AdamSeidman/SDAQ/README.md

# SDAQ
Stackable Data Acquisition System for RIT Baja.
