AdamSeidman/SDAQ/Boards/ADC Board/RevB/Gerber/SDAQ_ADCBoard_RevB.png

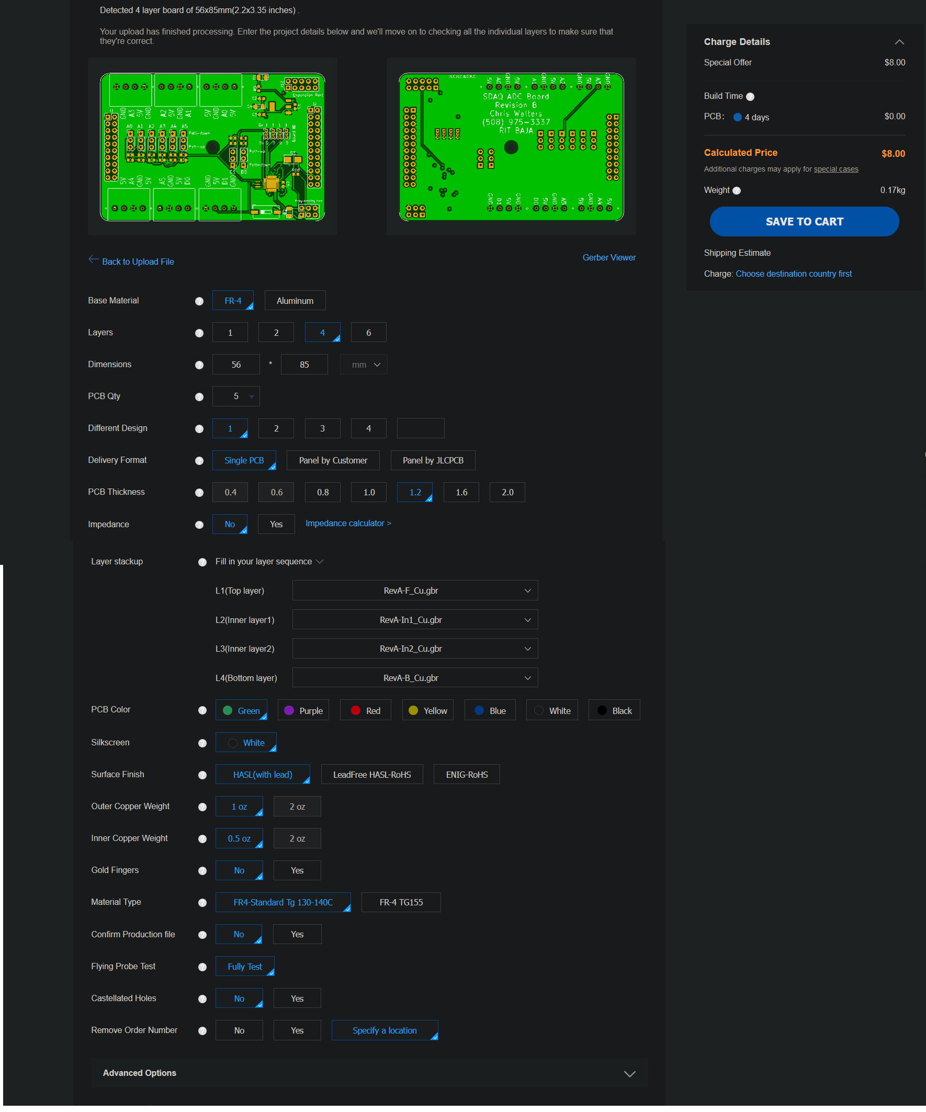
Boards/ADC Board/RevB/Gerber/SDAQ_ADCBoard_RevB.png
