AdamSeidman/SDAQ/Boards/Main Board/#Gerber/#Zips/Main_Board-RevB.png

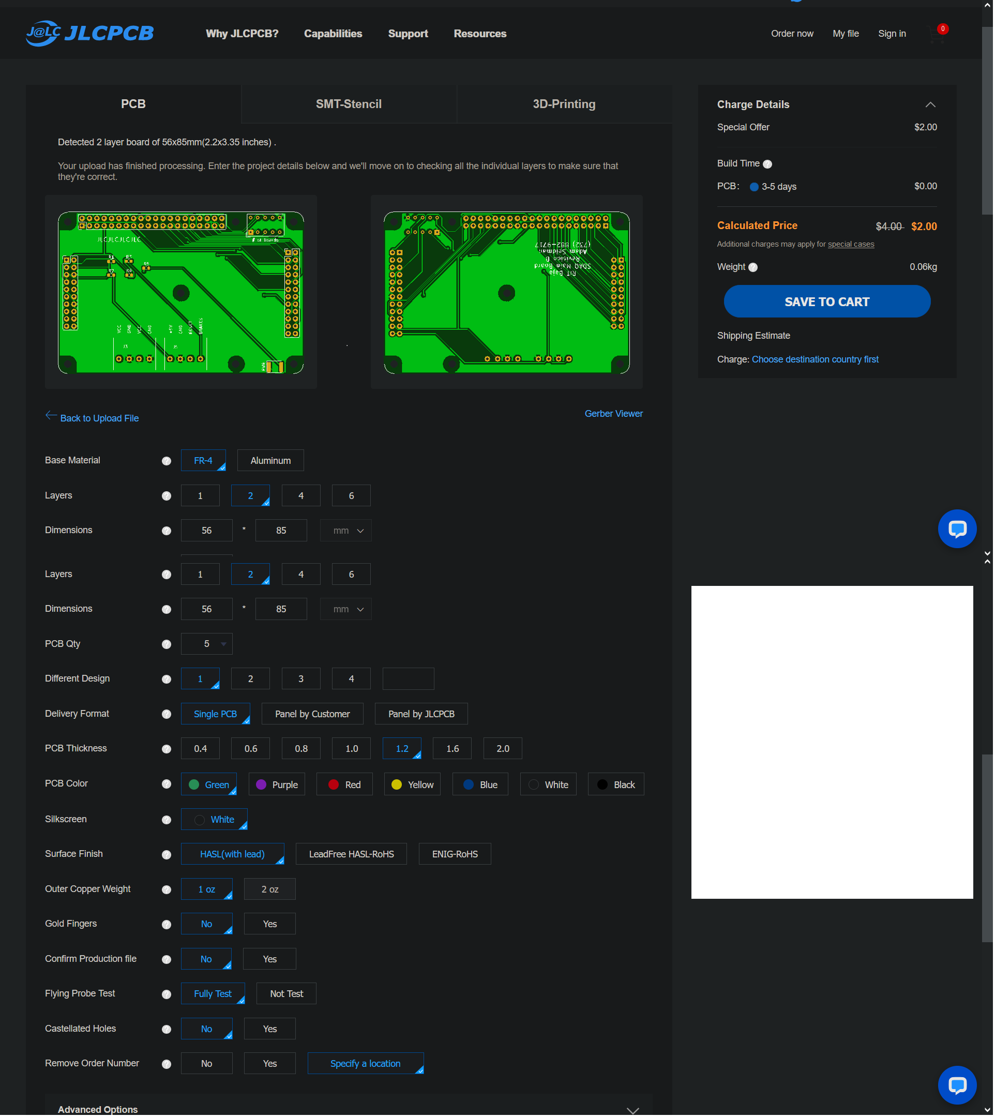
Boards/Main Board/#Gerber/#Zips/Main_Board-RevB.png
