AdamSeidman/SDAQ/Boards/Main Board/#Gerber/pcb_options.png

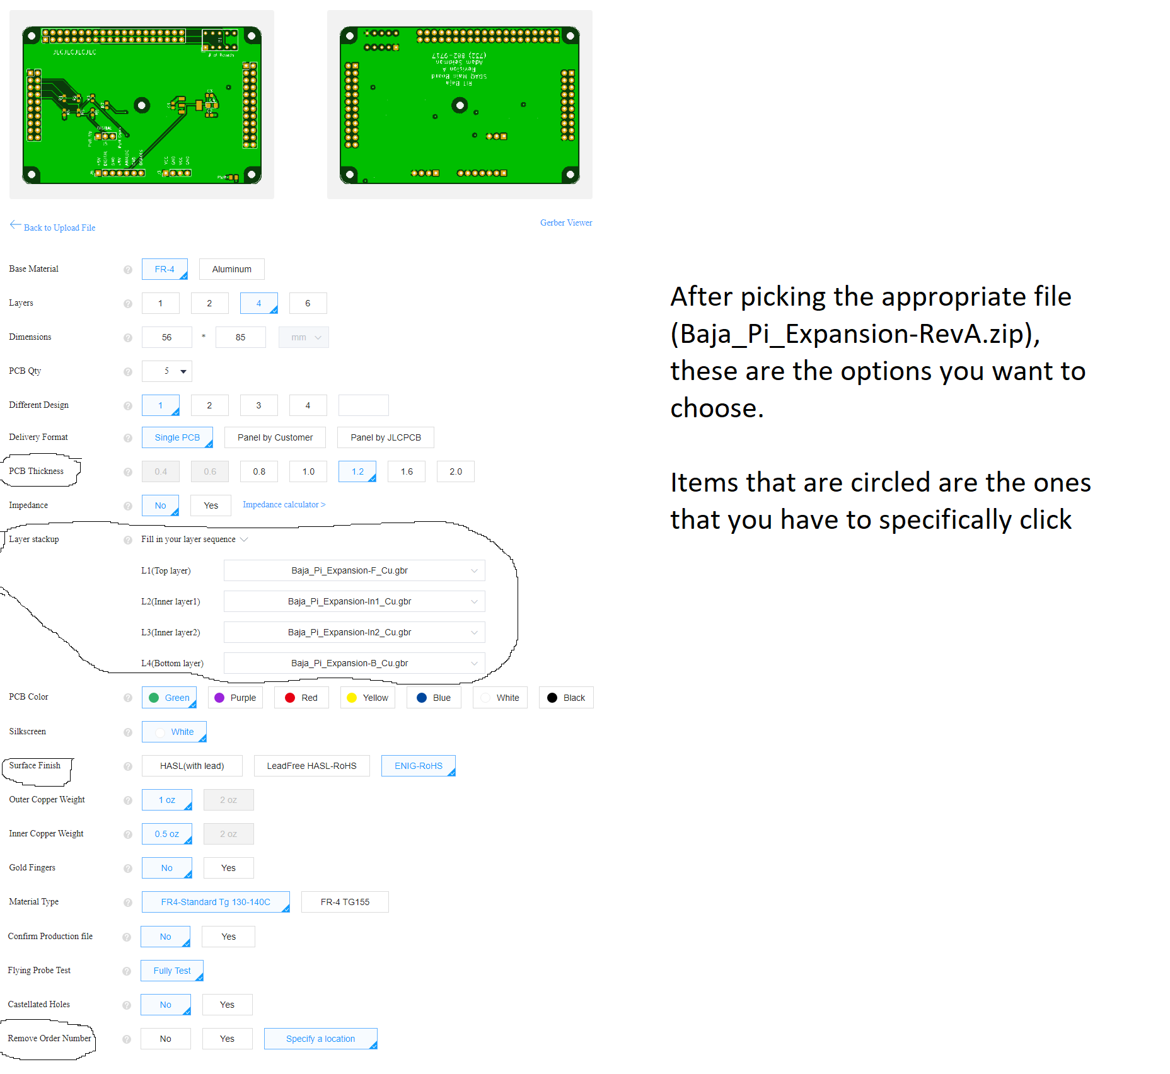
Boards/Main Board/#Gerber/pcb_options.png
