AdamSeidman/SDAQ/Resources/GPIO Pins for Raspberry Pi 4 (1).jpg

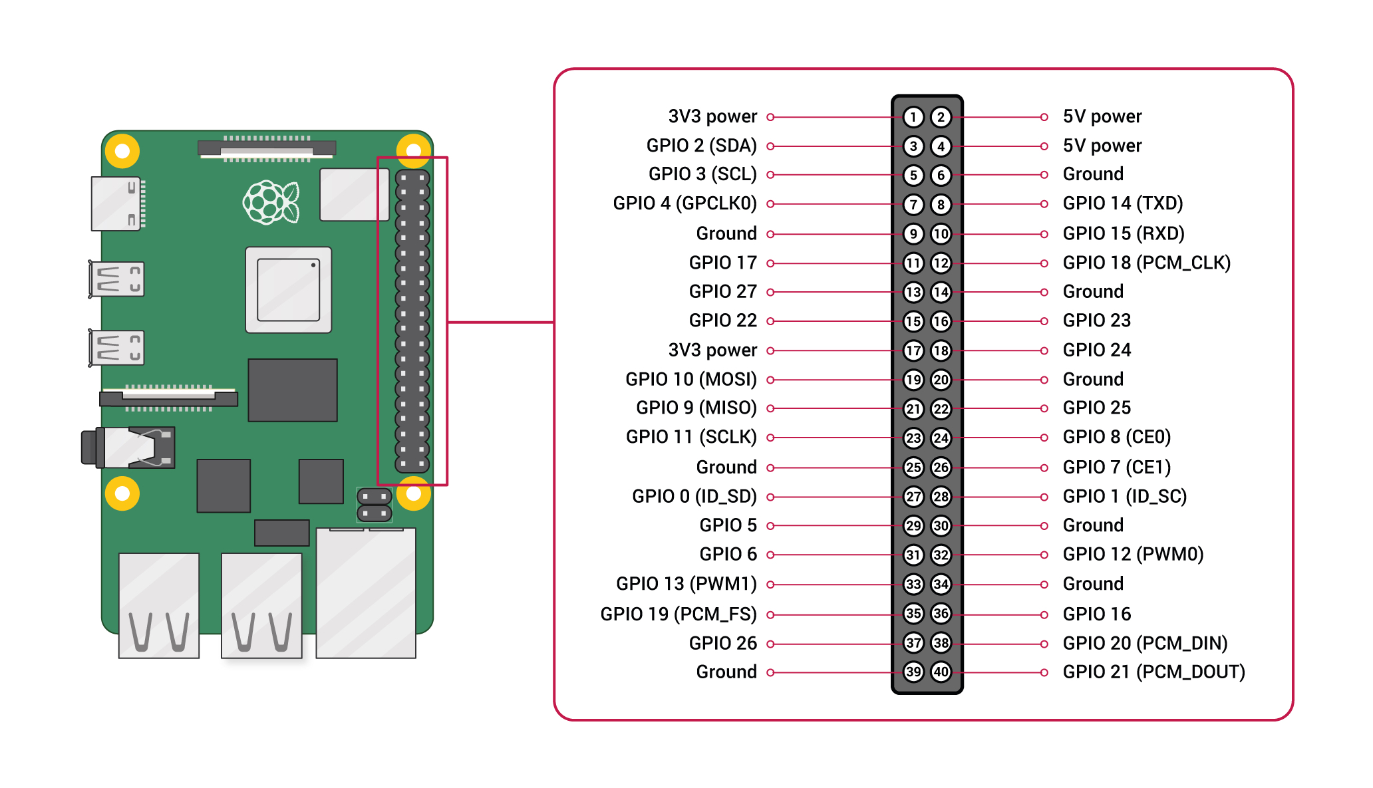
Resources/GPIO Pins for Raspberry Pi 4 (1).jpg
