AdamSeidman/SDAQ/Resources/GPIO Pins for Raspberry Pi 4 (2).jpg

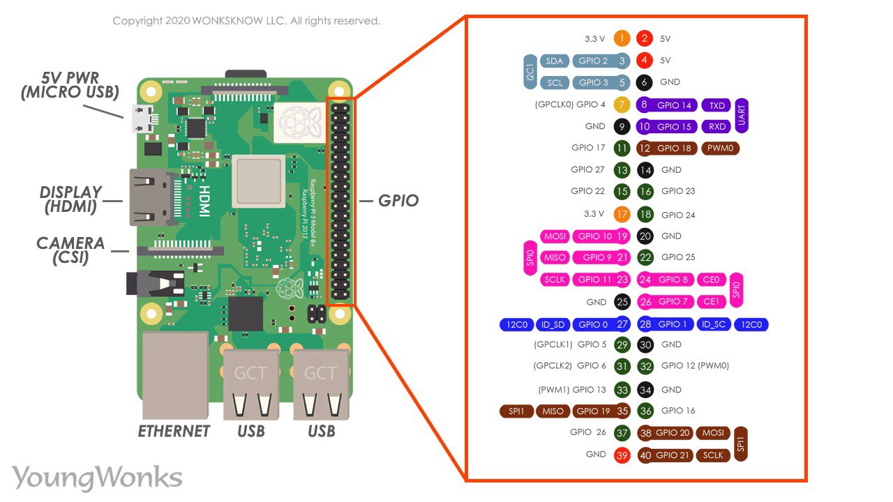
Resources/GPIO Pins for Raspberry Pi 4 (2).jpg
