AdamSeidman/SDAQ/Resources/Strain Gauge Schematic With Notes.png

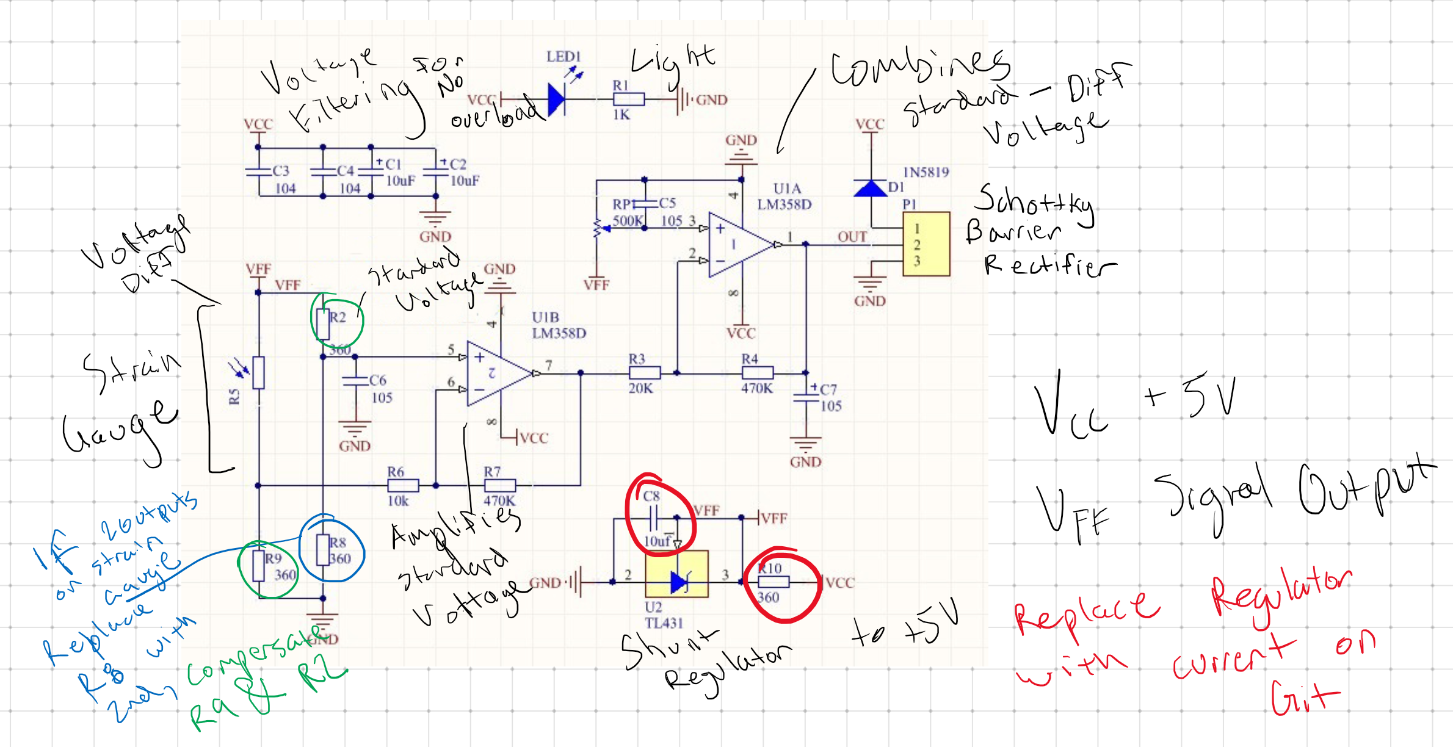
Resources/Strain Gauge Schematic With Notes.png
