AdamSeidman/SDAQ/Orders.xlsx

Sheet: Mouser Order
Description | Part # | Price ($) | Quantity | Total | Total: | 27.02
7 Pin spring terminal block | 651-1985247 | 1.1 | 3 | 3.3
4 Pin spring | 651-1984989 | 0.61 | 3 | 1.83
12 pin | 651-1985292 | 1.67 | 10 | 16.7
5V Regulator | 863-LM1117IMPXADJNOP | 0.519 | 10 | 5.19

Sheet: March 26 Order
Index | Quantity | Part Number | Manufacturer Part Number | Description | Customer Reference | Available | Backorder | Unit Price | Extended Price USD
1 | 10 | 563-CFS-0102CT-ND | CFS-0102TB | SWITCH DIP 1POS SPST 100MA 6V |  | 10 | 0 | 0.774 | 7.74
2 | 10 | 490-CSTNE16M0V53L000R0CT-ND | CSTNE16M0V53L000R0 | 3.2X1.3MM 16.0MHZ CERAMIC RESONA |  | 10 | 0 | 0.225 | 2.25
3 | 10 | LT1117CST-5#TRPBFCT-ND | LT1117CST-5#TRPBF | IC REG LINEAR 5V 800MA SOT223-3 |  | 10 | 0 | 5.172 | 51.72
4 | 50 | SAM12304-ND | TSW-103-14-F-S | CONN HEADER VERT 3POS 2.54MM |  | 50 | 0 | 0.381 | 19.05
5 | 30 | S9337-ND | QPC02SXGN-RC | CONN JUMPER SHORTING .100" GOLD |  | 30 | 0 | 0.0408 | 1.22
6 | 30 | 277-5744-ND | 1751264 | TERM BLK 4POS SIDE ENT 3.5MM PCB |  | 30 | 0 | 2.749 | 82.47
7 | 13 | Z2929-ND | G5Q-14 DC5 | RELAY GEN PURPOSE SPDT 10A 5V |  | 13 | 0 | 1.556 | 20.23
8 | 10 | SAM11096-ND | ESQ-110-13-L-D | CONN SOCKET 20POS 0.1 GOLD PCB |  | 10 | 0 | 6.01 | 60.1
9 | 5 | ESQ-120-13-T-D-ND | ESQ-120-13-T-D | CONN SOCKET 40POS 0.1 TIN PCB |  | 5 | 0 | 7.64 | 38.2
10 | 8 | SAM1204-12-ND | SSQ-112-03-T-D | CONN RCPT 24POS 0.1 TIN PCB |  | 8 | 0 | 2.56 | 20.48
11 | 7 | SAM11124-ND | ESW-105-12-L-D | CONN SOCKET 10POS 0.1 GOLD PCB |  | 7 | 0 | 2.99 | 20.93
12 | 7 | 609-77313-127-10LF-ND | 77313-127-10LF | CONN HEADER VERT 10POS 2.54MM |  | 7 | 0 | 0.62 | 4.34
13 | 7 | S2212EC-03-ND | PREC003DFAN-RC | CONN HEADER VERT 6POS 2.54MM |  | 7 | 0 | 0.16 | 1.12
14 | 20 | 296-52901-ND | LM358DG4 | IC OPAMP GP 2 CIRCUIT 8SOIC |  | 20 | 0 | 0.879 | 17.58
15 | 7 | BCS-103-T-D-TE-ND | BCS-103-T-D-TE | CONN RCPT 6POS 0.1 TIN PCB |  | 7 | 0 | 1.84 | 12.88
16 | 10 | 1195-6406-ND | 21348081380050 | CBL 3POS MALE TO FMALE 16.4' |  | 10 | 0 | 14.283 | 142.83

Sheet: Digikey Order
Description | Part # | Price ($) | Quantity | Total | Notes | Total: | 97.535
02x10 Pin Header F | S6106-ND | 1.26 | 3 | 3.78
02x12 Pin Header F | S7080-ND | 1.46 | 3 | 4.38
02x20 Pin Header F | S6104-ND | 2.29 | 3 | 6.87
7 Segment Display | 516-2271-ND | 3.48 | 3 | 10.44
LED | 1497-XZCDGK53W-8VFCT-ND | 0.413 | 15 | 6.195
Shunt | S9337-ND | 0.0408 | 25 | 1.02
3 Pin Jumper | SAM12304-ND | 0.364 | 10 | 3.64
02x10 Pin Header Thru | SAM1204-10-ND | 1.935 | 10 | 19.35
02x12 Pin Header Thru | SAM1204-12-ND | 2.321 | 10 | 23.21
04x03 Pin Jumper | A122856-ND | 4.39 | 4 | 17.56
1M Ohm | RMCF0805FT1M00CT-ND | 0.0109 | 100 | 1.09

Sheet: Amazon Order
Description | Price ($) | Quantity | Total | Link | Total: | 14.99
M2.5 Hardware Kit | 14.99 | 1 | 14.99 | https://www.amazon.com/Pastall-Raspberry-Installation-Standoff-Accessories/dp/B08MF8LDBS
