AdamSeidman/SDAQ/Boards/Main Board/Main_Board.xlsx

Sheet: Changelog
Revision A | Created board, Raspberry pi shield with 7 segment display, power terminal, dig-in and analog-in
Revision A1 | Fixed pullup-pulldown jumper on board

Sheet: Parts
Item | Use | PN/URL
02x10 Pin Header F | Left Expansion Header | S6106-ND
02x12 Pin Header F | Right Expansion Header | S7080-ND
02x20 Pin Header F | Pi Header | S6104-ND
7 Pin Screw Terminal | Sensor Input Terminal |  | (see if we have)
4 Pin Screw Terminal | Power Input Terminal |  | (see if we have)
7 Segment Display | # Boards Display | 516-2271-ND
LED | Power LED | 1497-XZCDGK53W-8VFCT-ND
Shunt | (For Jumper) | S9337-ND
3 Pin Jumper | Pullup/Pulldown Choice | SAM12304-ND | 609-3461-ND
5V Regulator | Pi Power Regulator | LM1117IMPX-5.0/NOPBCT-ND
4.7 uF Tantalum Cap | CPU Power Regulator | 478-8292-1-ND
1 uF Capacitor | Power Regulator (Both) | 490-10021-1-ND
0.1 uF Capacitor | Power Regulator (Not CPU) | 1292-1392-1-ND
10k Resistor | Generic Pullup/Pulldown | YAG2321CT-ND
4.7k Resistor | I2C Pullup Resistor | (See MR)
15.4k Resistor (?) | Brakes Divider #1 | (See MR)
(10k) | Brakes Divider #2 | (See Above)
200 Ohm Resistor | Power LED Resistor | P20201CT-ND
02x10 Pin Header Thru | Left Expansion Header | SAM1193-10-ND
02x12 Pin Header Thru | Right Expansion Header | SAM1193-12-ND
04x03 Pin Jumper | Pullup/Pulldown Choice *4 | A122856-ND | TSW-104-08-G-T-ND
M2.5 Hardware Kit | Mounting | https://www.amazon.com/Pastall-Raspberry-Installation-Standoff-Accessories/dp/B08MF8LDBS
