AdamSeidman/SDAQ/Boards/#Parts/keystone-PN1027.STEP

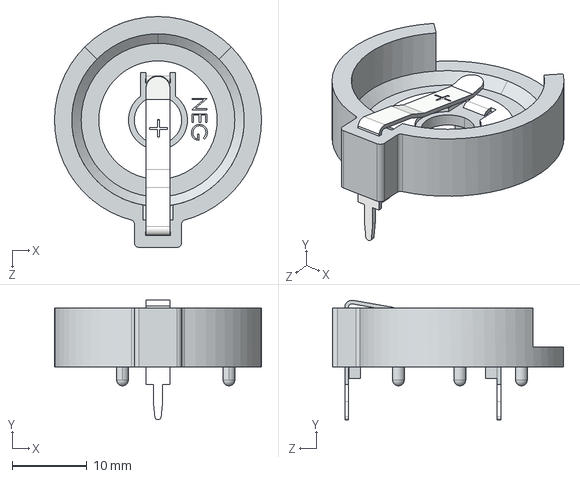
[picture p9: CAD file, 2021-10-08]
Boards/#Parts/keystone-PN1027.STEP
27.8 x 16.0 x 31.0 mm
