AdamSeidman/SDAQ/Boards/#Parts/ul_ATMEGA328PMUR/STEP/32M1-A_ATM.step

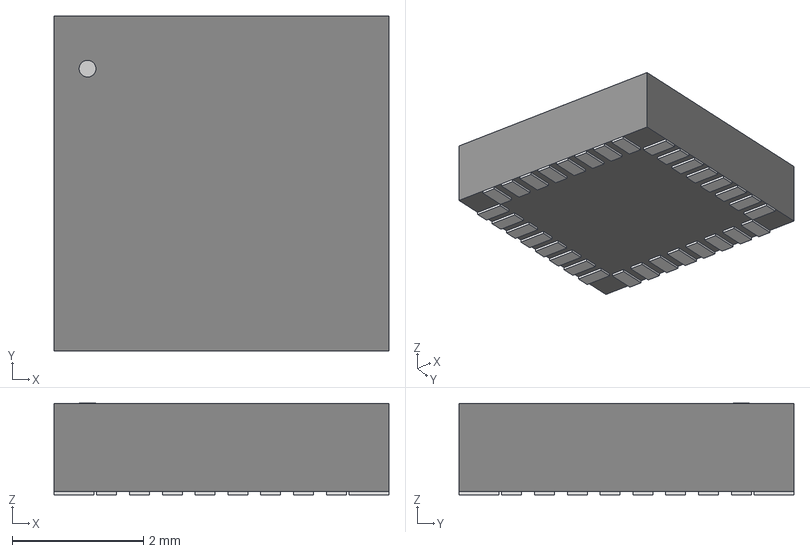
[picture p10: CAD file, 2022-03-16]
Boards/#Parts/ul_ATMEGA328PMUR/STEP/32M1-A_ATM.step
5.11 x 5.11 x 1.40 mm
