AdamSeidman/SDAQ/Boards/Strain_Gauge_Schmatic/LM358/LM358.step

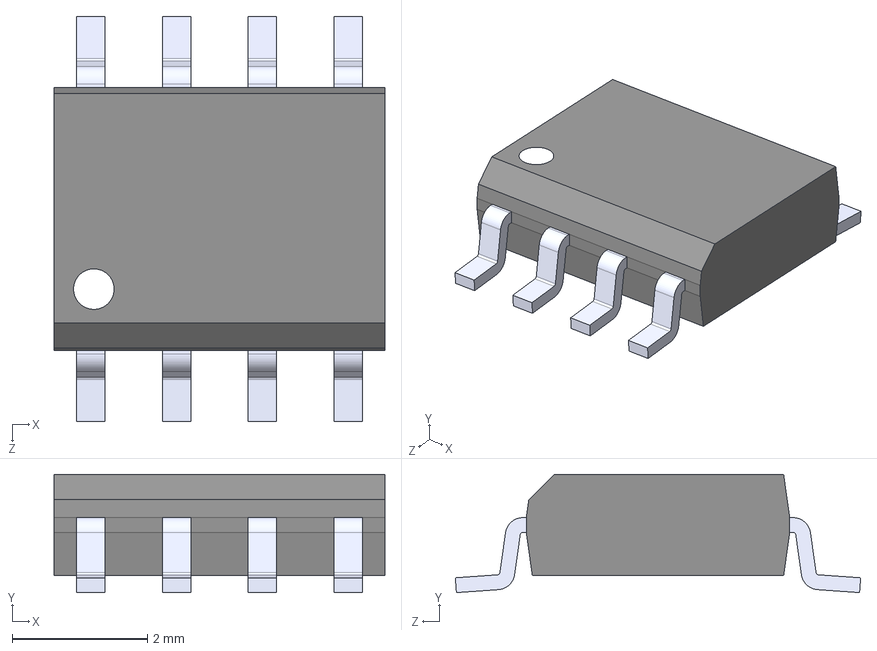
[picture p11: CAD file, 2022-02-05]
Boards/Strain_Gauge_Schmatic/LM358/LM358.step
4.90 x 1.75 x 6.00 mm
