AdamSeidman/SDAQ/Boards/Strain_Gauge_Schmatic/LM358/LM358M_NOPB.step

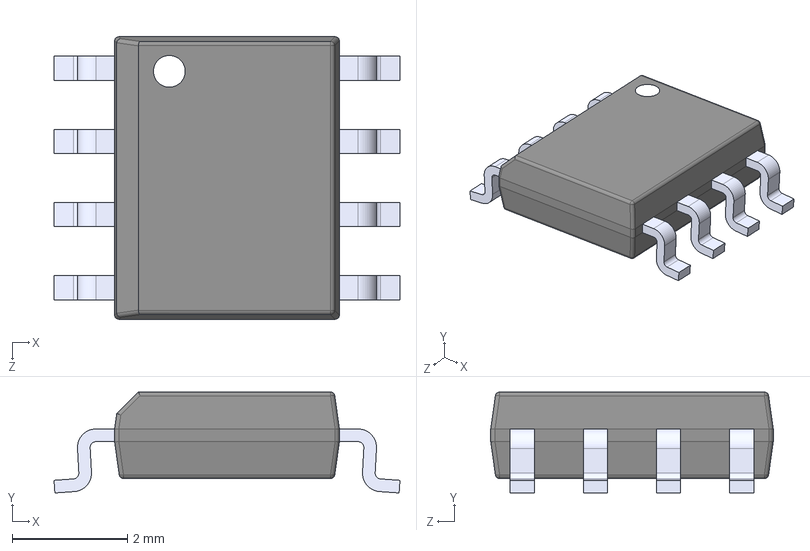
[picture p12: CAD file, 2022-02-05]
Boards/Strain_Gauge_Schmatic/LM358/LM358M_NOPB.step
6.00 x 1.75 x 4.90 mm
