AdamSeidman/SDAQ/Boards/#Parts/Female Pin Headers 3D/s91601-306lf/91601-306LFc.stp

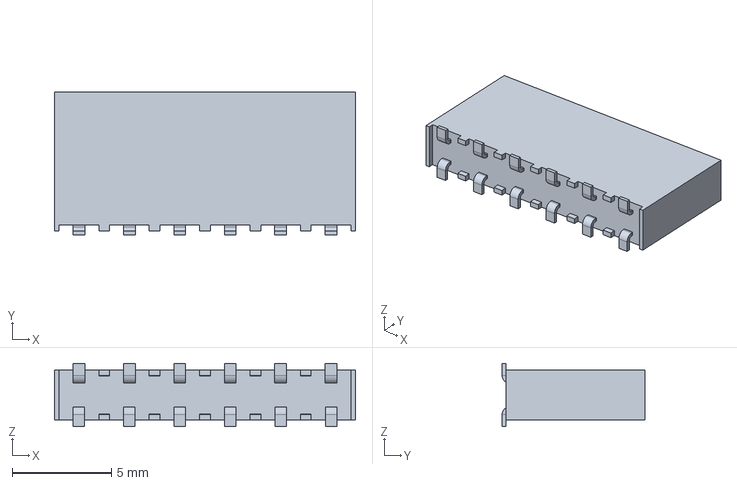
[picture p13: CAD file, 2021-10-08]
Boards/#Parts/Female Pin Headers 3D/s91601-306lf/91601-306LFc.stp
15.2 x 7.20 x 3.19 mm
