AdamSeidman/SDAQ/Boards/#Parts/Female Pin Headers 3D/s91601-308lf/91601-308LFc.stp

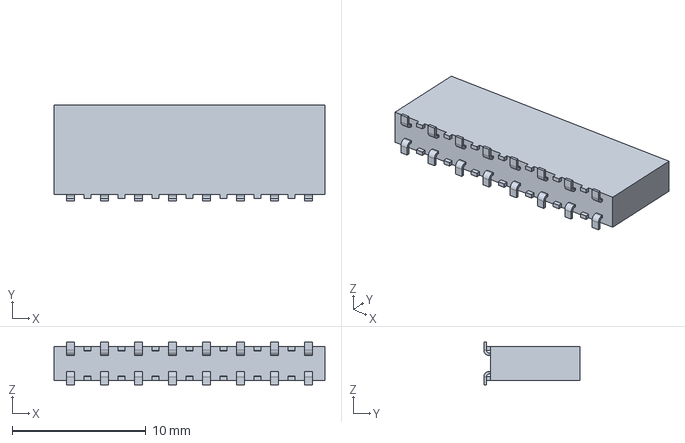
[picture p14: CAD file, 2021-10-08]
Boards/#Parts/Female Pin Headers 3D/s91601-308lf/91601-308LFc.stp
20.2 x 7.20 x 3.19 mm
