AdamSeidman/SDAQ/Boards/#Parts/Female Pin Headers 3D/s91601-412alf/91601-412ALFc.stp

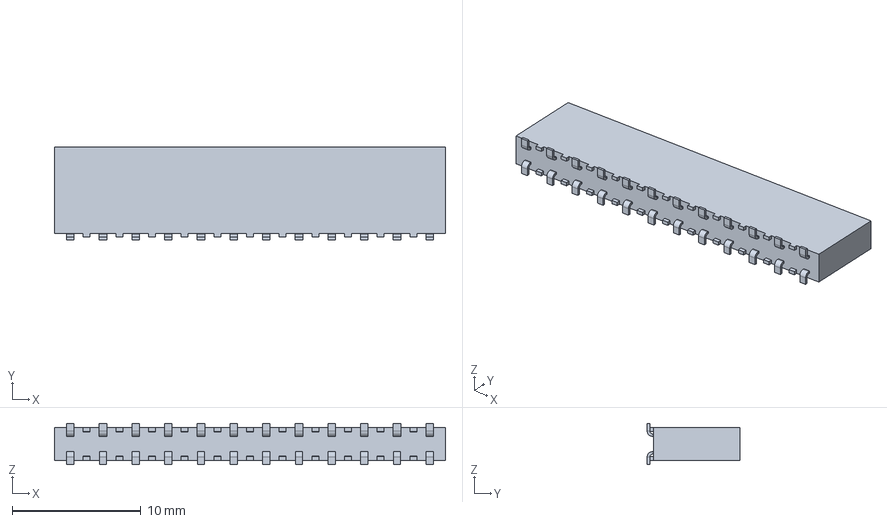
[picture p15: CAD file, 2021-10-08]
Boards/#Parts/Female Pin Headers 3D/s91601-412alf/91601-412ALFc.stp
30.4 x 7.20 x 3.19 mm
