AdamSeidman/SDAQ/(list of files, cad)

Other CAD files:
Boards/#Parts/ul_ATMEGA328PMUR/STEP/32M1-A_ATM-M.step
Boards/#Parts/ul_ATMEGA328PMUR/STEP/32M1-A_ATM-L.step
