AdamSeidman/SDAQ/Boards/Breadboard_Testbed/RevA/Gerber/Breadboard_Testbed-RevA.png

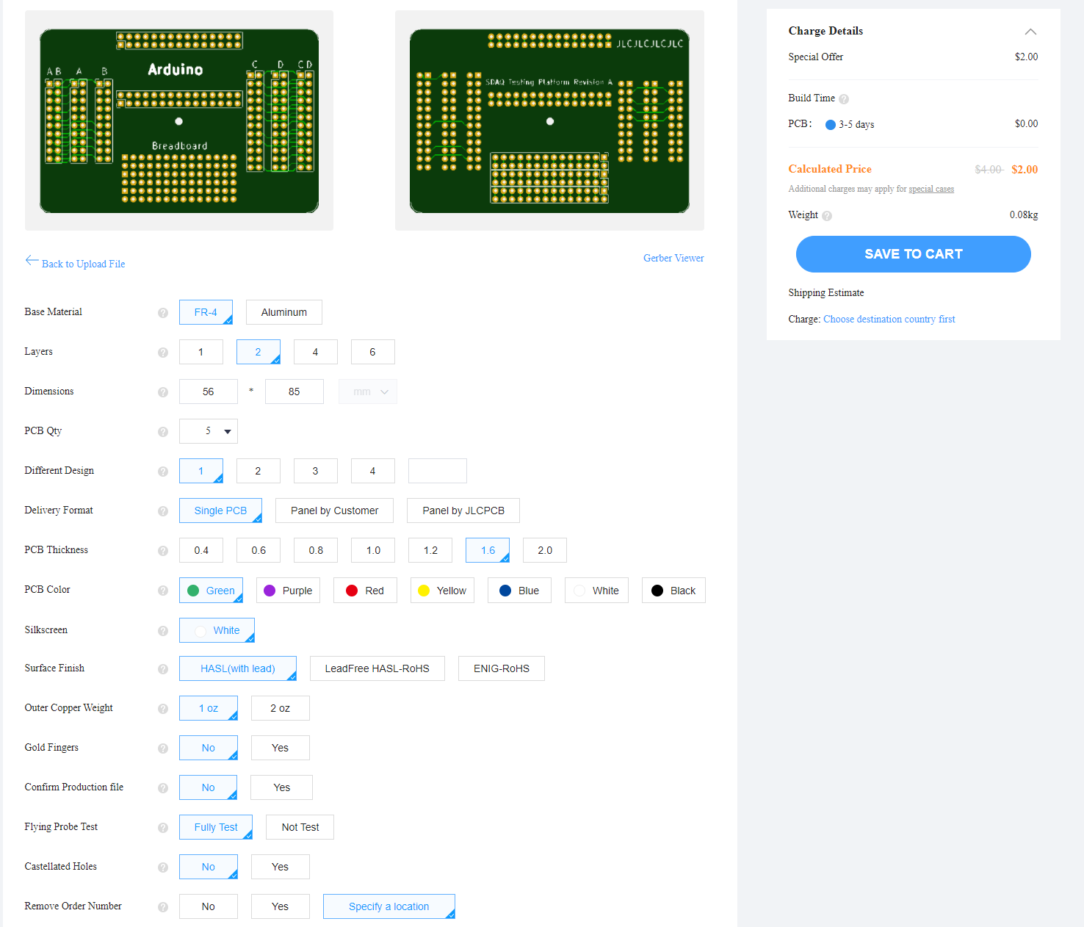
Boards/Breadboard_Testbed/RevA/Gerber/Breadboard_Testbed-RevA.png
