AdamSeidman/SDAQ/Data/4_22_Calibration/Notebook-Images/IMG20220423190747.jpg

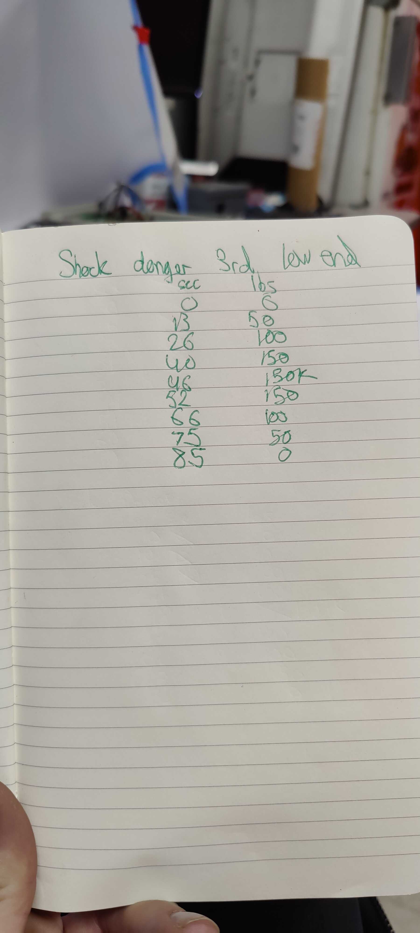
Data/4_22_Calibration/Notebook-Images/IMG20220423190747.jpg
