AdamSeidman/SDAQ/(list of files, drawings)

Other design files:
Boards/ADC Board/RevB/RevB1.dsn
Boards/ADC Board/RevB/RevB.dsn
Boards/Brakes Relay Board/RevB/relay_board.dsn
Boards/Breadboard_Testbed/RevA/Breadboard-Testbed.dsn
Boards/Main Board/RevB/Baja_Pi_Expansion/Baja_Pi_Expansion.dsn
Boards/Main Board/RevC/Baja_Pi_Expansion/Baja_Pi_Expansion.dsn
Boards/Main Board/RevD/Baja_Pi_Expansion/Baja_Pi_Expansion.dsn
Boards/Strain_Gauge_Schmatic/Strain_Guage_Schematic.dsn
