AdamSeidman/SDAQ/Boards/Brakes Relay Board/RevB/relay_board.kicad_pcb

## KiCad design Boards/Brakes Relay Board/RevB/relay_board.kicad_pcb (2022-05-28)

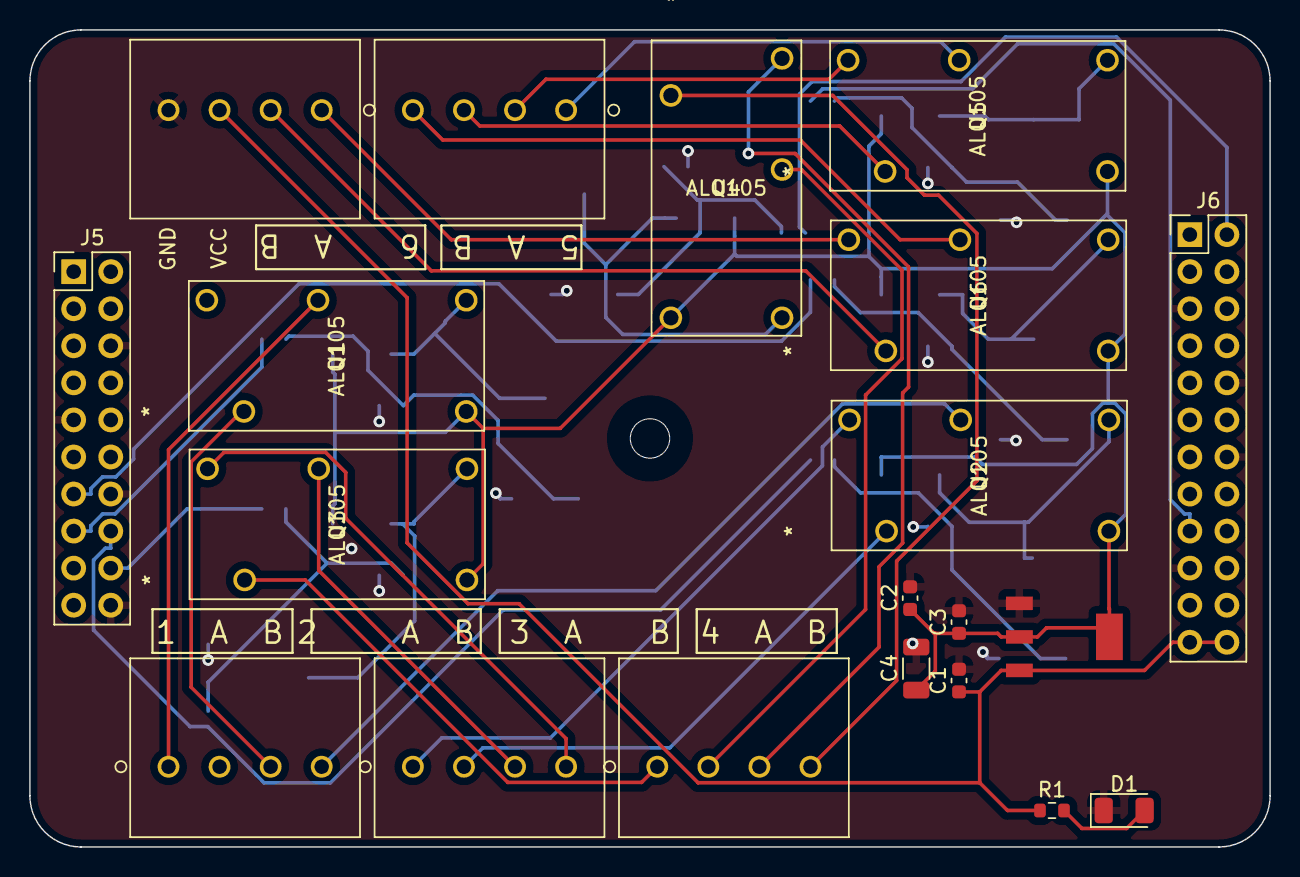
[picture p20: board relay_board.kicad_pcb from above]

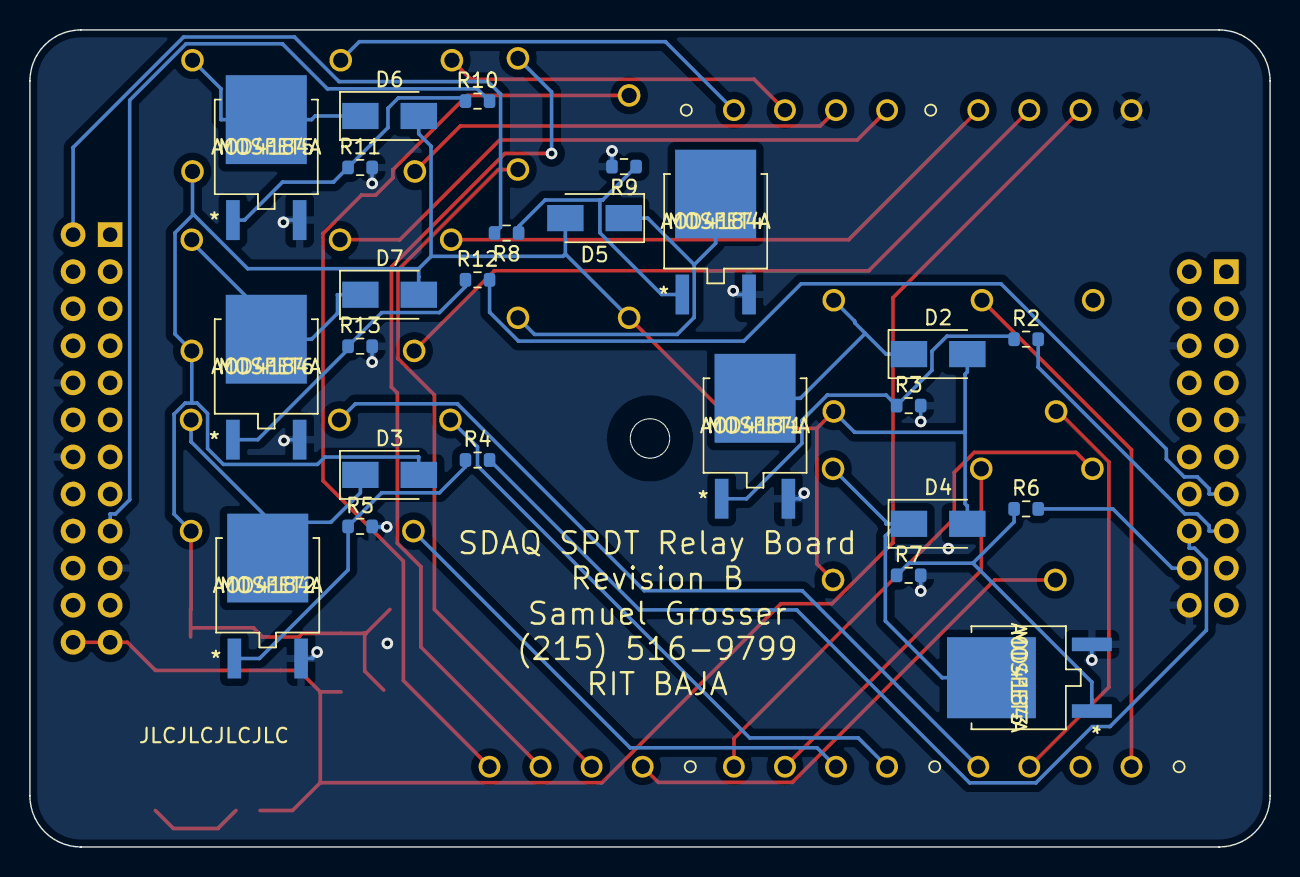
[picture p21: board relay_board.kicad_pcb from below]

Board: 2 copper layers, 85.0 x 56.0 mm, 44 parts (24 on the bottom side), 39 nets.

Parts:
C1, C2, C3: C_0603_1608Metric
C4: C_1206_3216Metric
D1: LED; D_1206_3216Metric
D2, D3, D4, D5, D6, D7: DIODE; D_SMA
J1, J2, J3, J4, J7: Screw_Terminal_01x04; 1984989
J5: Conn_02x10_Counter_Clockwise; PinHeader_2x10_P2.54mm_Vertical
J6: Conn_02x12_Counter_Clockwise; PinHeader_2x12_P2.54mm_Vertical
MOSFET1, MOSFET2, MOSFET3, MOSFET4, MOSFET5, MOSFET6: AOD4184A
R1: 1800; R_0603_1608Metric
R2, R4, R6, R8, R10, R12: 100; R_0603_1608Metric
R3, R5, R7, R9, R11, R13: 100k; R_0603_1608Metric
U1, U2, U3, U4, U5, U6: ALQ105
VR1: SOT230P700X180-4N

Connections:
+5V: C2.1, C3.1, C4.1, D2.2 (A), D3.2 (A), D4.2 (A), D5.2 (A), D6.2 (A), D7.2 (A), U1.4, U2.4, U3.4, U4.4, U5.4, U6.4, VR1.2 (VOUT2), VR1.4 (VOUT)
/Ch1: J1.1, U1.2
/Ch1B: J1.3, U1.5
/Ch2: J1.4, U2.2
/Ch2A: J2.1, U2.1
/Ch2B: J2.2, U2.5
/Ch3: J2.3, U3.2
/Ch3A: J2.4, U3.1
/Ch3B: J3.1, U3.5
/Ch4: J3.2, U4.2
/Ch4A: J3.3, U4.1
/Ch4B: J3.4, U4.5
/Ch5: J4.1, U5.2
/Ch5A: J4.2, U5.1
/Ch5B: J4.3, U5.5
/Ch6: J4.4, U6.2
/Ch6A: J7.1, U6.1
/Ch6B: J7.2, U6.5
/R0: J5.15, R2.2
/R1: J5.16, R4.2
/R2: J5.18, R6.2
/R3: J6.2, R8.2
/R4: J6.17, R10.2
/R5: J5.13, R12.2
/VCC: C1.1, J6.23, J6.24, J7.3, R1.1, VR1.3 (VIN)
GNDREF: C1.2, C2.2, C3.2, C4.2, D1.1 (K), J5.6, J5.9, J5.14, J5.20, J6.5, J6.10, J6.14, J6.19, J7.4, MOSFET1.3, MOSFET2.3, MOSFET3.3, MOSFET4.3, MOSFET5.3, MOSFET6.3, R3.2, R5.2, R7.2, R9.2, R11.2, R13.2, VR1.1 (ADJ/GND)
unnamed: D1.2 (A), R1.2
unnamed: D2.1 (K), MOSFET1.2, U1.3
unnamed: D3.1 (K), MOSFET2.2, U2.3
unnamed: D4.1 (K), MOSFET3.2, U3.3
unnamed: D5.1 (K), MOSFET4.2, U4.3
unnamed: D6.1 (K), MOSFET5.2, U5.3
unnamed: D7.1 (K), MOSFET6.2, U6.3
unnamed: MOSFET1.1, R2.1, R3.1
unnamed: MOSFET2.1, R4.1, R5.1
unnamed: MOSFET3.1, R6.1, R7.1
unnamed: MOSFET4.1, R8.1, R9.1
unnamed: MOSFET5.1, R10.1, R11.1
unnamed: MOSFET6.1, R12.1, R13.1
