AdamSeidman/SDAQ/Boards/Main Board/RevD/Baja_Pi_Expansion/Baja_Pi_Expansion.kicad_pcb

## KiCad design Boards/Main Board/RevD/Baja_Pi_Expansion/Baja_Pi_Expansion.kicad_pcb (2022-04-19)

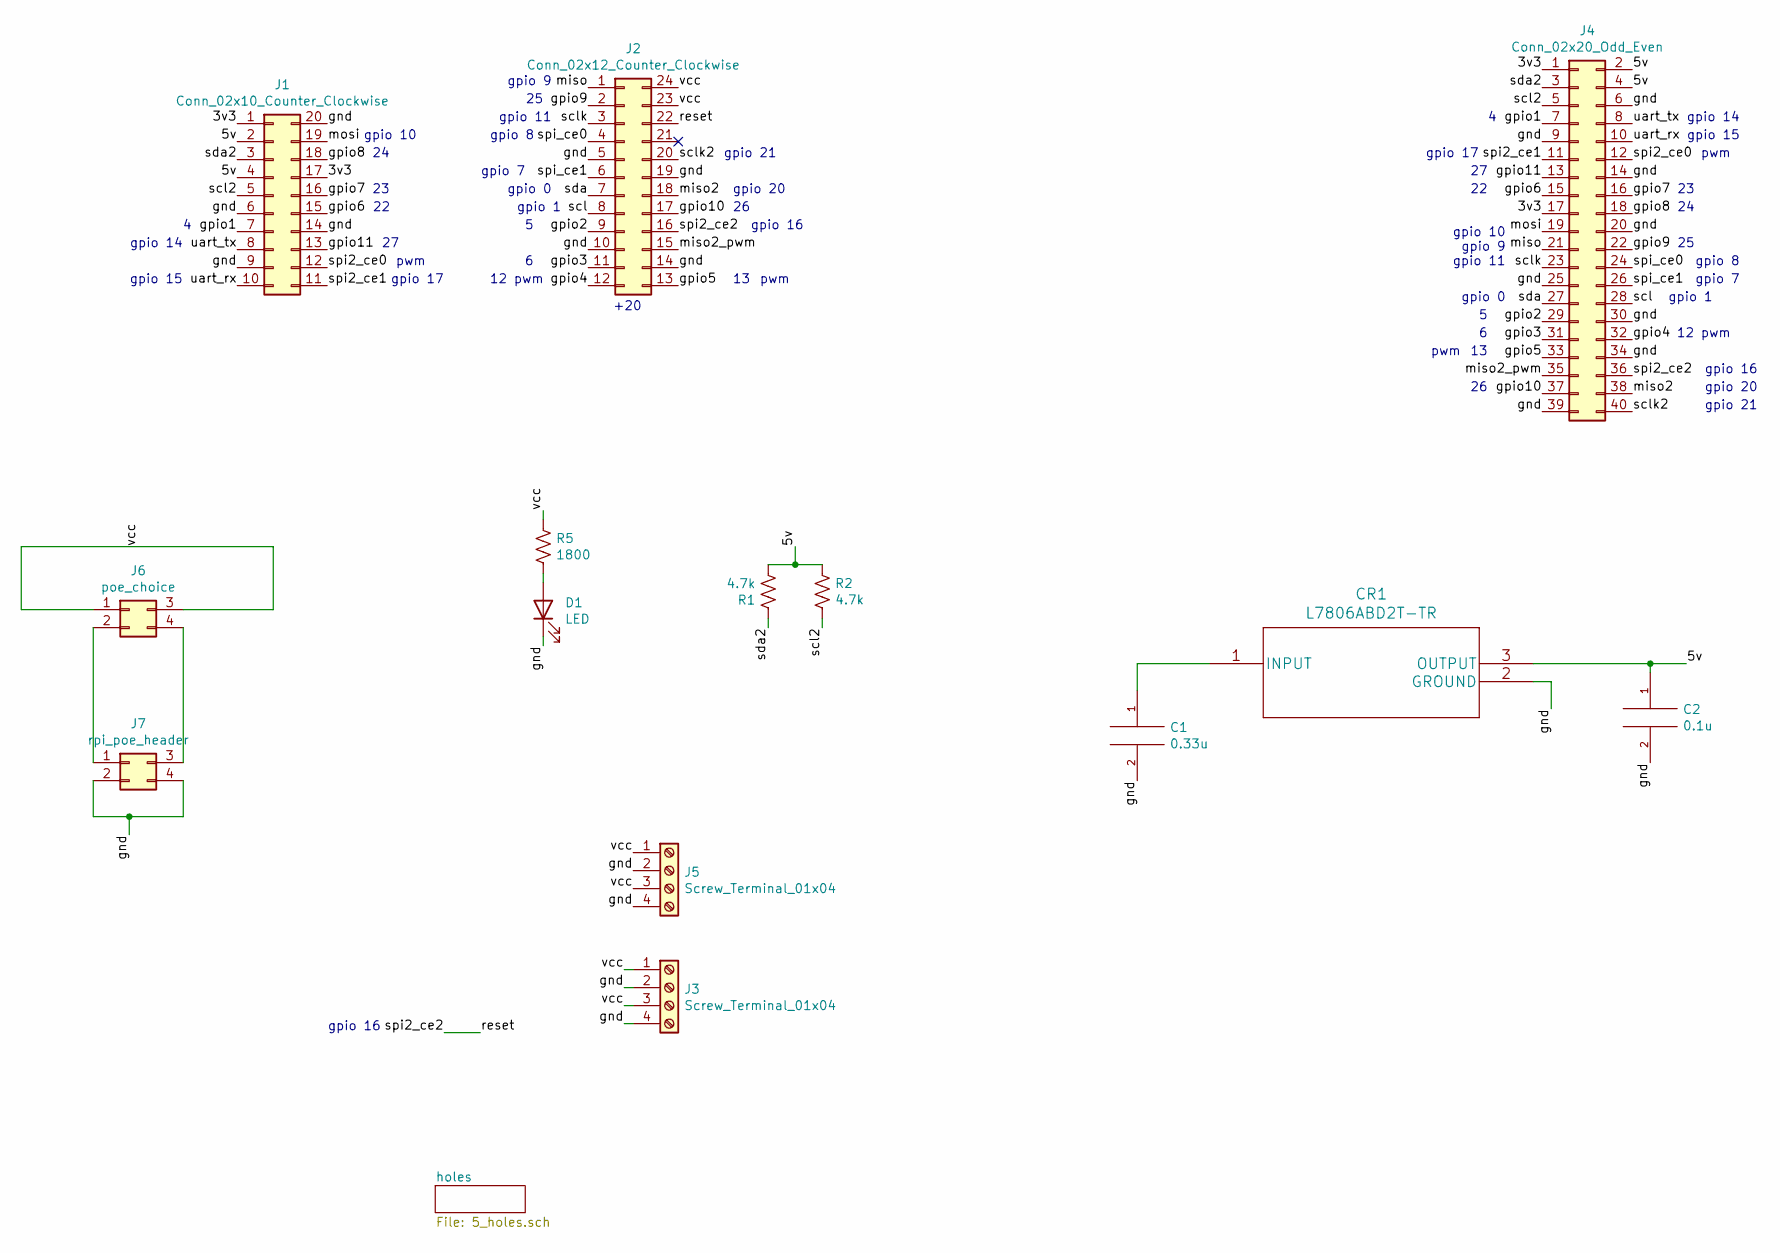
[picture p22: schematic Baja_Pi_Expansion.sch]

Parts:
C1: 0.33u; C_0603_1608Metric
C2: 0.1u; C_0603_1608Metric
CR1: L7806ABD2T-TR
D1: LED; D_1206_3216Metric
J1: Conn_02x10_Counter_Clockwise; PinHeader_2x10_P2.54mm_Vertical
J2: Conn_02x12_Counter_Clockwise; PinHeader_2x12_P2.54mm_Vertical
J3, J5: Screw_Terminal_01x04; Spring_4
J4: Conn_02x20_Odd_Even; PinHeader_2x20_P2.54mm_Vertical
J6: poe_choice; PinHeader_2x02_P2.54mm_Vertical
J7: rpi_poe_header; PinHeader_2x02_P2.54mm_Vertical
R1, R2: 4.7k; R_0603_1608Metric
R5: 1800; R_0603_1608Metric

Connections:
/3v3: J1.1, J1.17, J4.1, J4.17
/5v: C2.1, CR1.3 (OUTPUT), J1.2, J1.4, J4.2, J4.4, R1.1, R2.2
/gnd: C1.2, C2.2, CR1.2 (GROUND), D1.1 (K), J1.6, J1.9, J1.14, J1.20, J2.5, J2.10, J2.14, J2.19, J3.2, J3.4, J4.6, J4.9, J4.14, J4.20, J4.25, J4.30, J4.34, J4.39, J5.2, J5.4, J7.2, J7.4
/gpio1: J1.7, J4.7
/gpio2: J2.9, J4.29
/gpio3: J2.11, J4.31
/gpio4: J2.12, J4.32
/gpio5: J2.13, J4.33
/gpio6: J1.15, J4.15
/gpio7: J1.16, J4.16
/gpio8: J1.18, J4.18
/gpio9: J2.2, J4.22
/gpio10: J2.17, J4.37
/gpio11: J1.13, J4.13
/miso: J2.1, J4.21
/miso2: J2.18, J4.38
/miso2_pwm: J2.15, J4.35
/mosi: J1.19, J4.19
/reset: J2.16, J2.22, J4.36
/scl: J2.8, J4.28
/scl2: J1.5, J4.5, R2.1
/sclk: J2.3, J4.23
/sclk2: J2.20, J4.40
/sda: J2.7, J4.27
/sda2: J1.3, J4.3, R1.2
/spi2_ce0: J1.12, J4.12
/spi2_ce1: J1.11, J4.11
/spi_ce0: J2.4, J4.24
/spi_ce1: J2.6, J4.26
/uart_rx: J1.10, J4.10
/uart_tx: J1.8, J4.8
/vcc: J2.23, J2.24, J3.1, J3.3, J5.1, J5.3, J6.1, J6.3, R5.1
unnamed: C1.1, CR1.1 (INPUT)
unnamed: D1.2 (A), R5.2
unnamed: J6.2, J7.1
unnamed: J6.4, J7.3

Notes on the sheet:
pwm
gpio 14
gpio 15
gpio 17
gpio 8
gpio 7
gpio 1
12 pwm
gpio 16
gpio 20
gpio 21
gpio 10 gpio 9 gpio 11
gpio 0
gpio 11
gpio 10
gpio 9
+20

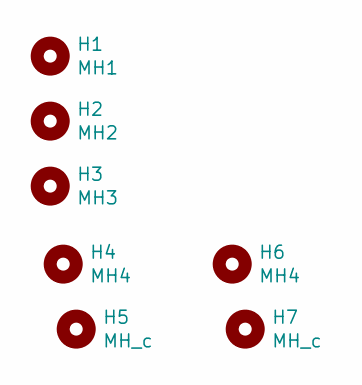
[picture p23: schematic 5_holes.sch]

Parts:
H1: MH1; MountingHole_2.7mm_M2.5
H2: MH2; MountingHole_2.7mm_M2.5
H3: MH3; MountingHole_2.7mm_M2.5
H4, H6: MH4; MountingHole_2.7mm_M2.5
H5, H7: MH_c; MountingHole_2.7mm_M2.5

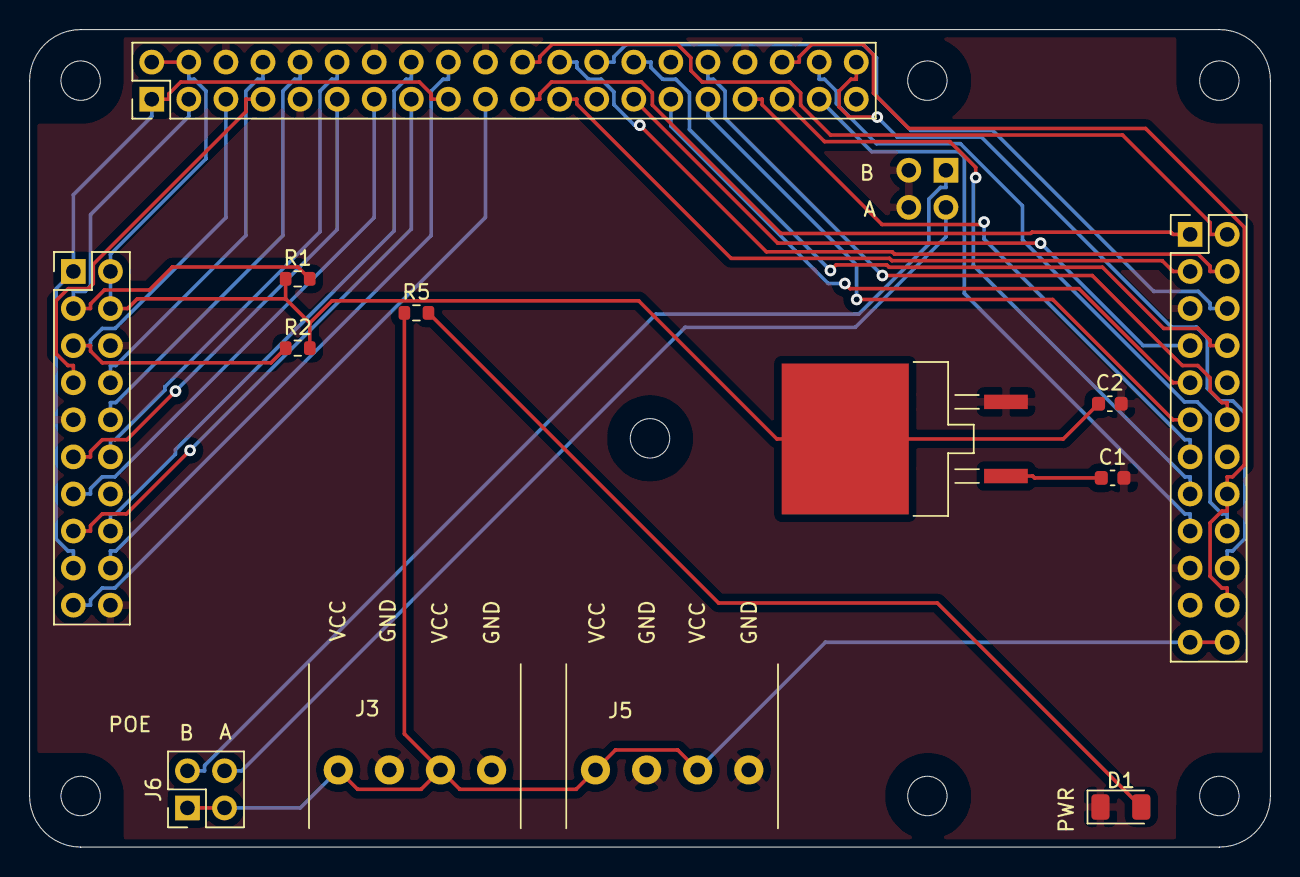
[picture p24: board Baja_Pi_Expansion.kicad_pcb from above]

Board: 2 copper layers, 85.0 x 56.0 mm, 21 parts (1 on the bottom side), 36 nets.
