AdamSeidman/SDAQ/Boards/ADC Board/RevB/RevA.kicad_pcb

## KiCad design Boards/ADC Board/RevB/RevA.kicad_pcb (2022-03-21)

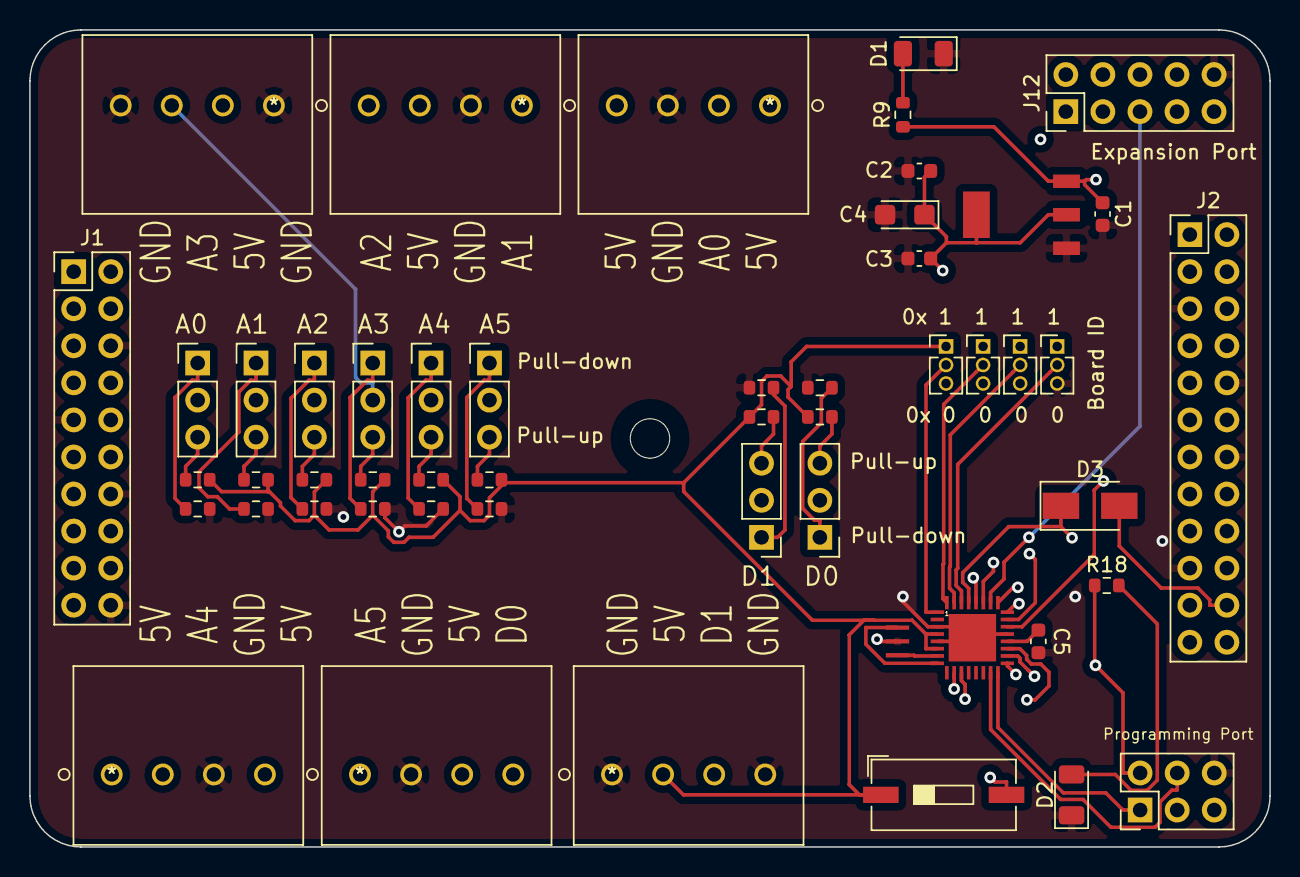
[picture p25: board Boards/ADC Board/RevB/RevA.kicad_pcb from above]

Board: 4 copper layers, 85.0 x 56.0 mm, 53 parts (0 on the bottom side), 45 nets.

Parts:
C1: 0.1uF; C_0603_1608Metric
C2: 1uF; C_0603_1608Metric
C3: 1uF_cpu; C_0603_1608Metric
C4: 4.7uF_16V_cpu; CP_EIA-3216-18_Kemet-A
C5: 100nF; C_0603_1608Metric
D1, D2: LED; LED_1206_3216Metric
D3: DIODE; D_SMA
J1: Left Connector; PinHeader_2x10_P2.54mm_Vertical
J2: Right Connector; PinHeader_2x12_P2.54mm_Vertical
J3, J4, J5, J22: Conn_01x03_Female; PinHeader_1x03_P1.27mm_Vertical
J6, J7, J8, J9, J10, J11: Screw_Terminal_01x04; 1984989
J12: Conn_02x05_Top_Bottom; PinHeader_2x05_P2.54mm_Vertical
J13, J14, J15, J16, J17, J18, J19, J20: Conn_01x03_Male; PinHeader_1x03_P2.54mm_Vertical
J21: Conn_02x03_Odd_Even; PinHeader_2x03_P2.54mm_Vertical
M2.5: CMH; MountingHole_2.7mm_M2.5
R1, R2, R3, R4, R5, R6, R7, R8, R10, R11, R12, R13, R14, R15, R16, R17: 10k; R_0603_1608Metric
R9, R18: 1.8k; R_0603_1608Metric
SW1: SW_DIP_x01; SW_DIP_SPSTx01_Slide_9.78x4.72mm_W8.61mm_P2.54mm
U1: ATMEGA328P-MUR
VR1: LM1117IMPX-5.0; SOT230P700X180-4N
Y1: CSTCE16M0V53-R0; OSC_CSTCE16M0V53-R0

Connections:
/3.3V: J1.1, J1.17
/5V: J3.1, J4.1, J5.1, J6.1, J6.4, J7.3, J8.2, J9.1, J9.4, J10.3, J11.2, J12.1, J21.2, J22.1, R1.2, R3.2, R5.2, R7.2, R10.2, R12.2, R14.2, R16.2, R18.1, SW1.1, U1.4, U1.6, U1.18
/5v_regulator/5V: C2.1, C3.1, C4.1, SW1.2, VR1.2, VR1.4
/A0: J6.2, J12.2, J13.2, U1.23
/A1: J7.1, J12.3, J14.2, U1.24
/A2: J7.4, J12.4, J15.2, U1.25
/A3: J8.3, J12.5, J16.2, U1.26
/A4: J9.2, J12.6, J17.2, U1.19
/A5: J10.1, J12.7, J18.2, U1.22
/A6: J10.4, J12.8, J19.2, U1.10
/A7: J11.3, J12.9, J20.2, U1.11
/Arduino/D0: J3.2, U1.30
/Arduino/D1: J4.2, U1.31
/Arduino/D2: J5.2, U1.32
/Arduino/D3: J22.2, U1.1
/Arduino/MISO: J21.1, U1.16
/Arduino/MOSI: J21.4, U1.15
/Arduino/SCK: J21.3, U1.17
/GND: C1.2, C2.2, C3.2, C4.2, C5.1, D1.1, D2.1, J1.6, J1.9, J1.14, J1.20, J2.5, J2.10, J2.14, J2.19, J3.3, J4.3, J5.3, J6.3, J7.2, J8.1, J8.4, J9.3, J10.2, J11.1, J11.4, J12.10, J21.6, J22.3, R2.2, R4.2, R6.2, R8.2, R11.2, R13.2, R15.2, R17.2, U1.3, U1.5, U1.21, U1.33, VR1.1, Y1.2
/I2C_Clock: J1.5, U1.28
/I2C_Data: J1.3, U1.27
/Reset: D3.2, J21.5, U1.29
/VCC: C1.1, J2.23, J2.24, R9.1, VR1.3
unnamed: C5.2, U1.20
unnamed: D1.2, R9.2
unnamed: D2.2, R18.2
unnamed: D3.1, J2.22
unnamed: J13.1, R2.1
unnamed: J13.3, R1.1
unnamed: J14.1, R4.1
unnamed: J14.3, R3.1
unnamed: J15.1, R6.1
unnamed: J15.3, R5.1
unnamed: J16.1, R8.1
unnamed: J16.3, R7.1
unnamed: J17.1, R11.1
unnamed: J17.3, R10.1
unnamed: J18.1, R13.1
unnamed: J18.3, R12.1
unnamed: J19.1, R15.1
unnamed: J19.3, R14.1
unnamed: J20.1, R17.1
unnamed: J20.3, R16.1
unnamed: U1.7, Y1.1
unnamed: U1.8, Y1.3
