AdamSeidman/SDAQ/Boards/Strain_Gauge_Schmatic/Strain_Guage_Schematic.kicad_pcb

## KiCad design Boards/Strain_Gauge_Schmatic/Strain_Guage_Schematic.kicad_pcb (2022-02-14)

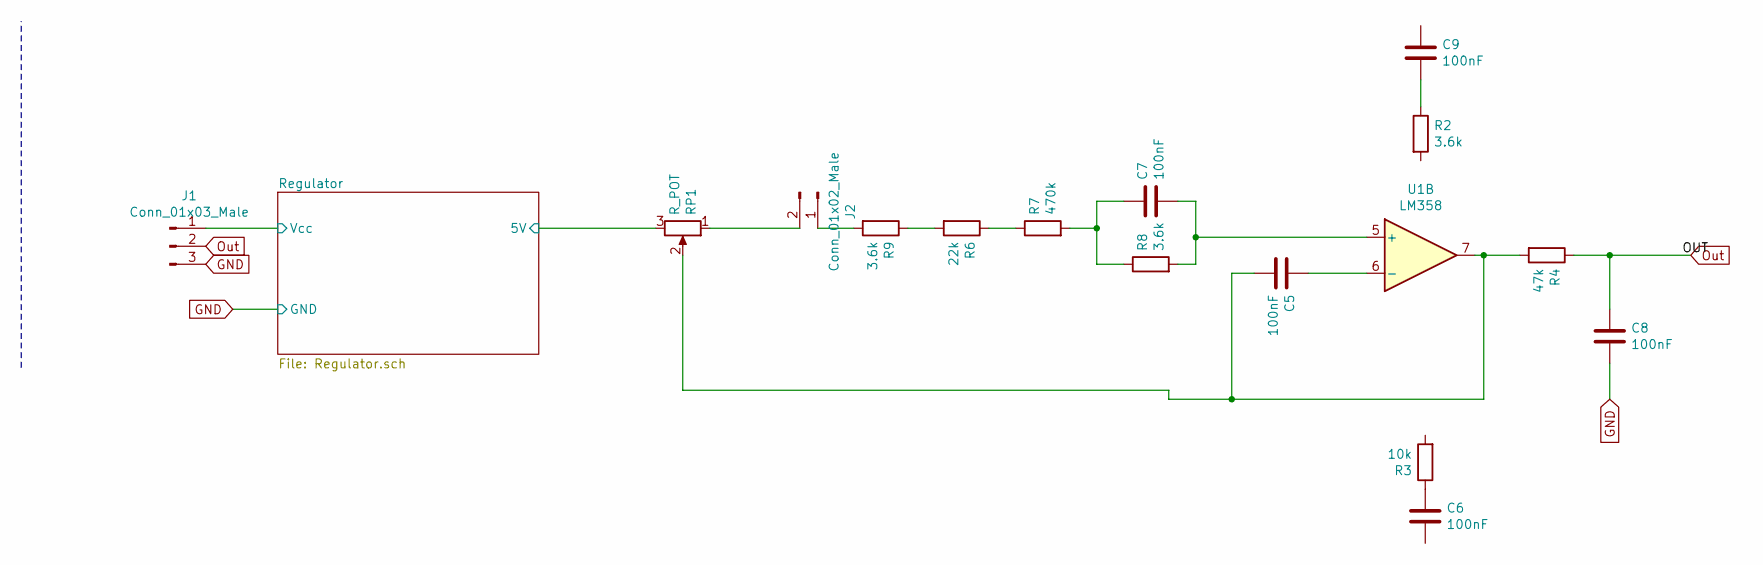
[picture p26: schematic Strain_Guage_Schematic.sch]

Parts:
C5, C6, C7, C8, C9: 100nF; C_0603_1608Metric
J1: Conn_01x03_Male; PinHeader_1x03_P1.00mm_Vertical
J2: Conn_01x02_Male; PinHeader_1x02_P1.00mm_Vertical
R2, R8, R9: 3.6k; R_0603_1608Metric
R3: 10k; R_0603_1608Metric
R4: 47k; R_0603_1608Metric
R6: 22k; R_0603_1608Metric
R7: 470k; R_0603_1608Metric
RP1: R_POT; Potentiometer_Bourns_3296W_Vertical
U1: LM358; SOIC127P599X175-8N

Connections:
/Regulator/5V: RP1.3; also elsewhere on the board
/Regulator/Vcc: J1.1; also elsewhere on the board
GND: C8.2, J1.3; also elsewhere on the board
unnamed: C5.1, U1.6 (-)
unnamed: C5.2, R4.2, RP1.2, U1.7
unnamed: C6.1, R3.1
unnamed: C7.1, R7.2, R8.1
unnamed: C7.2, R8.2, U1.5 (+)
unnamed: C9.2, R2.1
unnamed: J2.1, R9.2
unnamed: J2.2, RP1.1
unnamed: R6.1, R7.1
unnamed: R6.2, R9.1
Out: C8.1, J1.2, R4.1

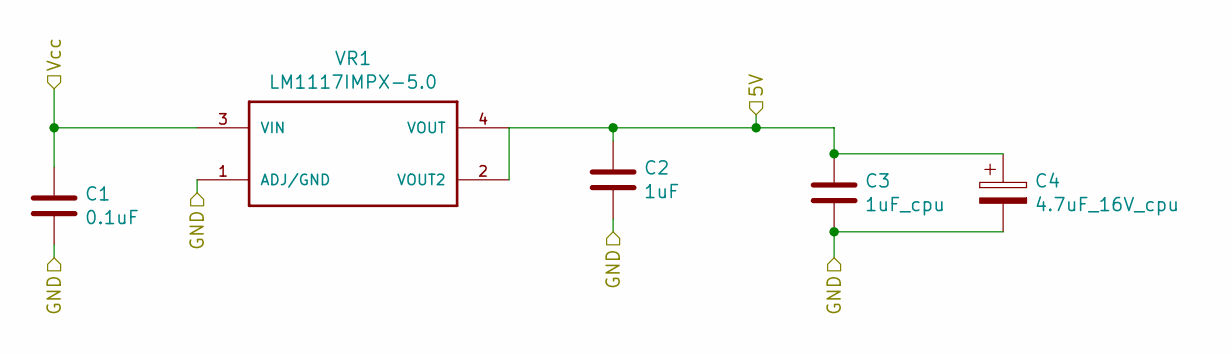
[picture p27: schematic Regulator.sch]

Parts:
C1: 0.1uF; C_0603_1608Metric
C2: 1uF; C_0603_1608Metric
C3: 1uF_cpu; C_0603_1608Metric
C4: 4.7uF_16V_cpu; C_0603_1608Metric
VR1: LM1117IMPX-5.0; SOT230P700X180-4N

Connections:
/Regulator/5V: C2.1, C3.1, C4.1, VR1.2 (VOUT2), VR1.4 (VOUT); also elsewhere on the board
/Regulator/Vcc: C1.1, VR1.3 (VIN); also elsewhere on the board
GND: C1.2, C2.2, C3.2, C4.2, VR1.1 (ADJ/GND); also elsewhere on the board

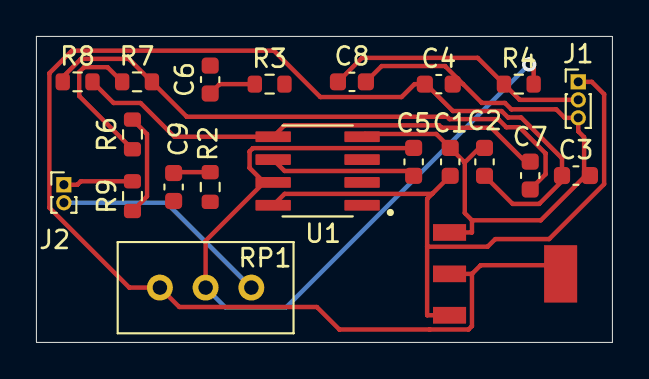
[picture p28: board Strain_Guage_Schematic.kicad_pcb from above]

Board: 2 copper layers, 32.0 x 17.0 mm, 21 parts (0 on the bottom side), 14 nets.
