AdamSeidman/SDAQ/Boards/Breadboard_Testbed/RevA/Breadboard-Testbed.kicad_pcb

## KiCad design Boards/Breadboard_Testbed/RevA/Breadboard-Testbed.kicad_pcb (2022-02-04)

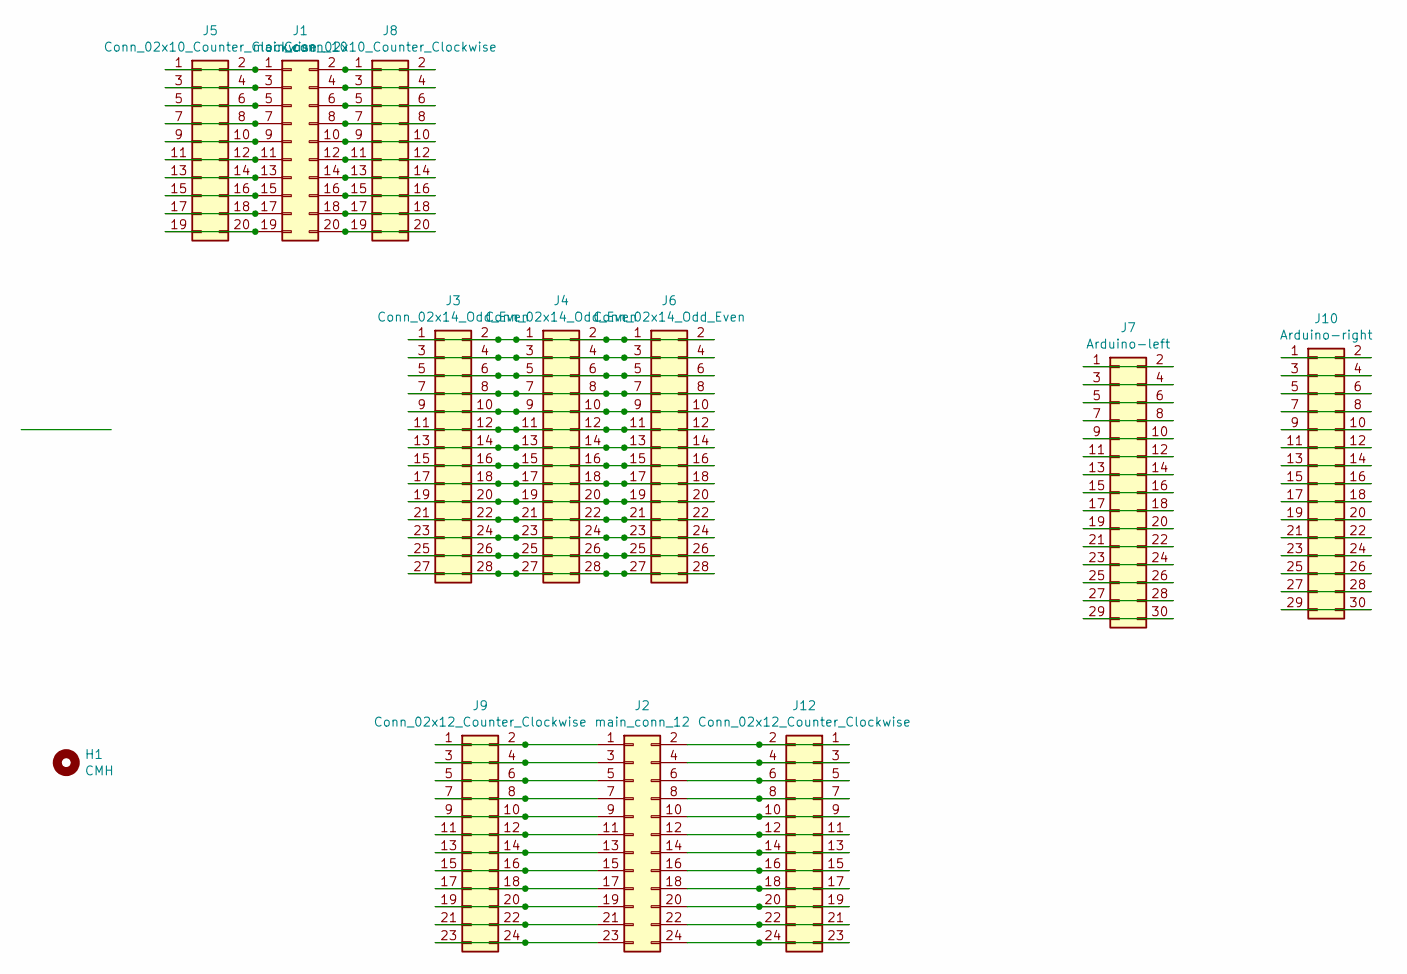
[picture p29: schematic Breadboard-Testbed.sch]

Parts:
H1: CMH; MountingHole_2.5mm
J1: main_conn_10; PinHeader_2x10_P2.54mm_Vertical
J2: main_conn_12; PinHeader_2x12_P2.54mm_Vertical
J3, J4, J6: Conn_02x14_Odd_Even; PinHeader_2x14_P2.54mm_Vertical
J5, J8: Conn_02x10_Counter_Clockwise; PinHeader_2x10_P2.54mm_Vertical
J7: Arduino-left; PinHeader_2x15_P2.54mm_Vertical
J9, J12: Conn_02x12_Counter_Clockwise; PinHeader_2x12_P2.54mm_Vertical
J10: Arduino-right; PinHeader_2x15_P2.54mm_Vertical

Connections:
unnamed: J1.1, J5.1, J5.2
unnamed: J1.2, J8.1, J8.2
unnamed: J1.3, J5.3, J5.4
unnamed: J1.4, J8.3, J8.4
unnamed: J1.5, J5.5, J5.6
unnamed: J1.6, J8.5, J8.6
unnamed: J1.7, J5.7, J5.8
unnamed: J1.8, J8.7, J8.8
unnamed: J1.9, J5.9, J5.10
unnamed: J1.10, J8.9, J8.10
unnamed: J1.11, J5.11, J5.12
unnamed: J1.12, J8.11, J8.12
unnamed: J1.13, J5.13, J5.14
unnamed: J1.14, J8.13, J8.14
unnamed: J1.15, J5.15, J5.16
unnamed: J1.16, J8.15, J8.16
unnamed: J1.17, J5.17, J5.18
unnamed: J1.18, J8.17, J8.18
unnamed: J1.19, J5.19, J5.20
unnamed: J1.20, J8.19, J8.20
unnamed: J2.1, J9.1, J9.2
unnamed: J2.3, J9.3, J9.4
unnamed: J2.5, J9.5, J9.6
unnamed: J2.7, J9.7, J9.8
unnamed: J2.9, J9.9, J9.10
unnamed: J2.11, J9.11, J9.12
unnamed: J2.13, J9.13, J9.14
unnamed: J2.15, J9.15, J9.16
unnamed: J2.17, J9.17, J9.18
unnamed: J2.19, J9.19, J9.20
unnamed: J2.21, J9.21, J9.22
unnamed: J2.23, J9.23, J9.24
unnamed: J3.1, J3.2, J4.1, J4.2, J6.1, J6.2
unnamed: J3.3, J3.4, J4.3, J4.4, J6.3, J6.4
unnamed: J3.5, J3.6, J4.5, J4.6, J6.5, J6.6
unnamed: J3.7, J3.8, J4.7, J4.8, J6.7, J6.8
unnamed: J3.9, J3.10, J4.9, J4.10, J6.9, J6.10
unnamed: J3.11, J3.12, J4.11, J4.12, J6.11, J6.12
unnamed: J3.13, J3.14, J4.13, J4.14, J6.13, J6.14
unnamed: J3.15, J3.16, J4.15, J4.16, J6.15, J6.16
unnamed: J3.17, J3.18, J4.17, J4.18, J6.17, J6.18
unnamed: J3.19, J3.20, J4.19, J4.20, J6.19, J6.20
unnamed: J3.21, J3.22, J4.21, J4.22, J6.21, J6.22
unnamed: J3.23, J3.24, J4.23, J4.24, J6.23, J6.24
unnamed: J3.25, J3.26, J4.25, J4.26, J6.25, J6.26
unnamed: J3.27, J3.28, J4.27, J4.28, J6.27, J6.28
unnamed: J7.1, J7.2
unnamed: J7.3, J7.4
unnamed: J7.5, J7.6
unnamed: J7.7, J7.8
unnamed: J7.9, J7.10
unnamed: J7.11, J7.12
unnamed: J7.13, J7.14
unnamed: J7.15, J7.16
unnamed: J7.17, J7.18
unnamed: J7.19, J7.20
unnamed: J7.21, J7.22
unnamed: J7.23, J7.24
unnamed: J7.25, J7.26
unnamed: J7.27, J7.28
unnamed: J7.29, J7.30
unnamed: J10.1, J10.2
unnamed: J10.3, J10.4
unnamed: J10.5, J10.6
unnamed: J10.7, J10.8
unnamed: J10.9, J10.10
unnamed: J10.11, J10.12
unnamed: J10.13, J10.14
unnamed: J10.15, J10.16
unnamed: J10.17, J10.18
unnamed: J10.19, J10.20
unnamed: J10.21, J10.22
unnamed: J10.23, J10.24
unnamed: J10.25, J10.26
unnamed: J10.27, J10.28
unnamed: J10.29, J10.30
unnamed: J2.2, J12.1, J12.2
unnamed: J2.4, J12.3, J12.4
unnamed: J2.6, J12.5, J12.6
unnamed: J2.8, J12.7, J12.8
unnamed: J2.10, J12.9, J12.10
unnamed: J2.12, J12.11, J12.12
unnamed: J2.14, J12.13, J12.14
unnamed: J2.16, J12.15, J12.16
unnamed: J2.18, J12.17, J12.18
unnamed: J2.20, J12.19, J12.20
unnamed: J2.22, J12.21, J12.22
unnamed: J2.24, J12.23, J12.24

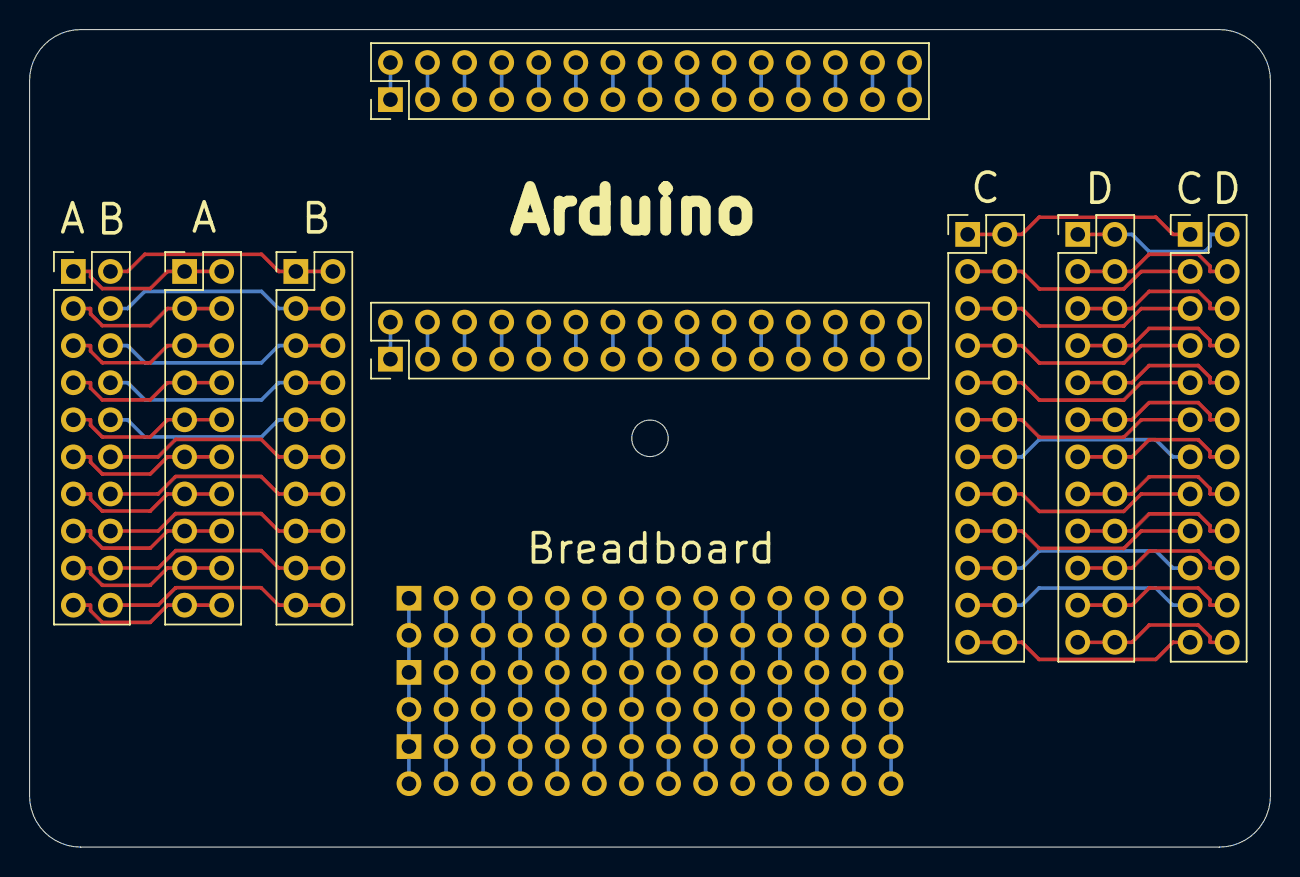
[picture p30: board Breadboard-Testbed.kicad_pcb from above]

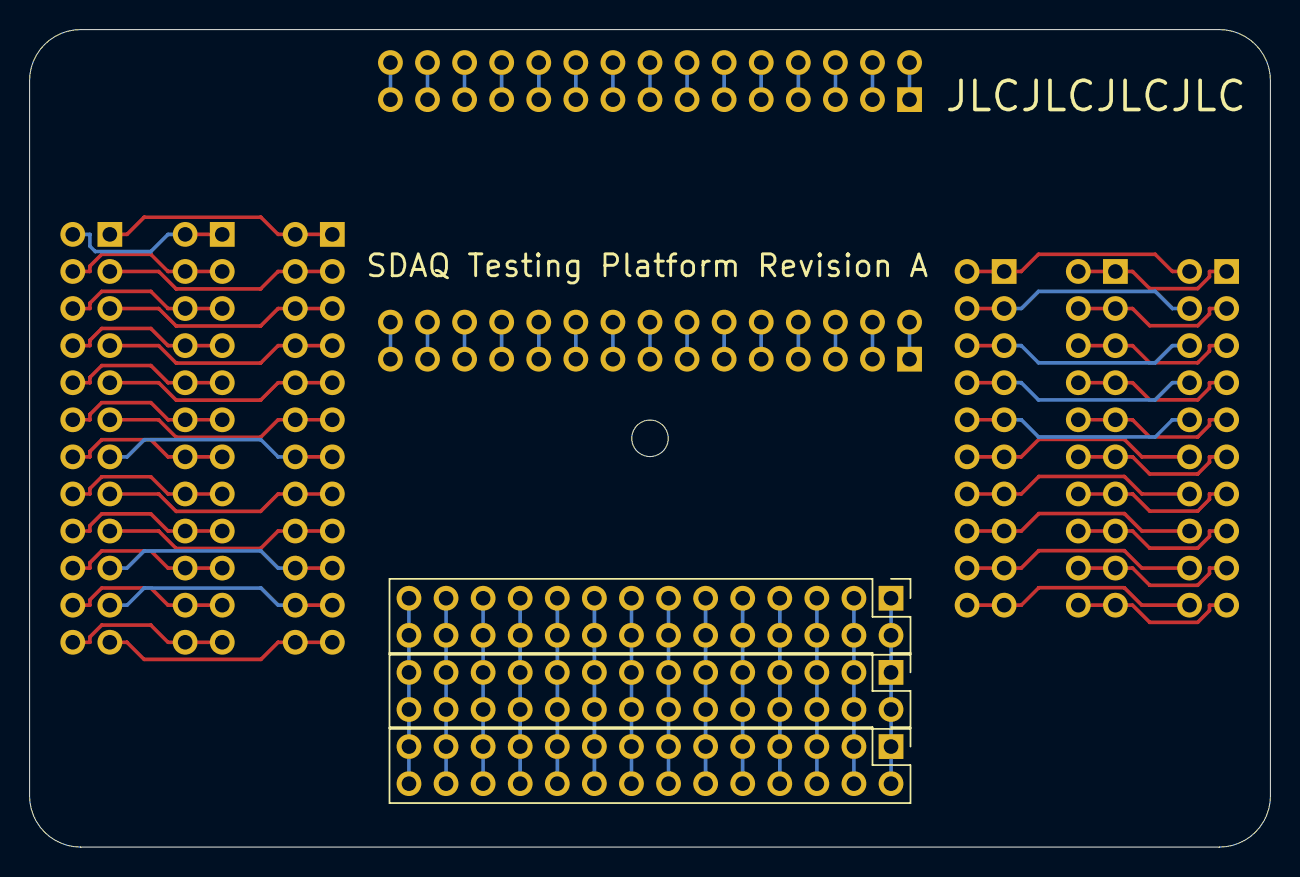
[picture p31: board Breadboard-Testbed.kicad_pcb from below]

Board: 2 copper layers, 85.0 x 56.0 mm, 12 parts (3 on the bottom side), 88 nets.
