AdamSeidman/SDAQ/Boards/ADC Board/RevA1/RevA.kicad_pcb

## KiCad design Boards/ADC Board/RevA1/RevA.kicad_pcb (2022-03-16)

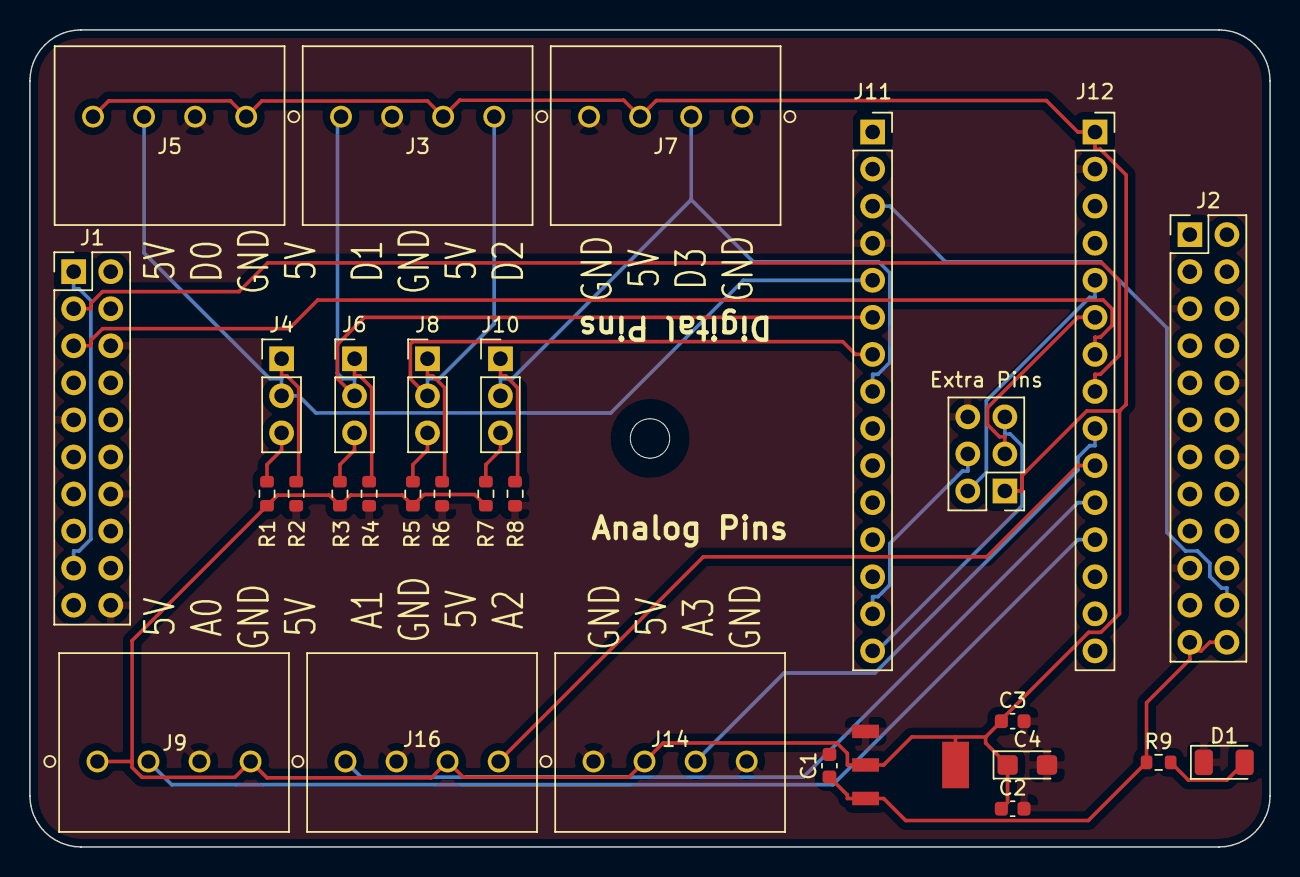
[picture p32: board Boards/ADC Board/RevA1/RevA.kicad_pcb from above]

Board: 2 copper layers, 85.0 x 56.0 mm, 31 parts (0 on the bottom side), 28 nets.

Parts:
C1: 0.1uF; C_0603_1608Metric
C2: 1uF; C_0603_1608Metric
C3: 1uF_cpu; C_0603_1608Metric
C4: 4.7uF_16V_cpu; CP_EIA-3216-18_Kemet-A
D1: LED; LED_1206_3216Metric
J1: Left Connector; PinHeader_2x10_P2.54mm_Vertical
J2: Right Connector; PinHeader_2x12_P2.54mm_Vertical
J3, J5, J7, J9, J14, J16: Screw Terminals; 1984989
J4, J6, J8, J10: Jumper Terminals; PinHeader_1x03_P2.54mm_Vertical
J11: Arduino Nano L; PinSocket_1x15_P2.54mm_Vertical
J12: Arduino Nano R; PinSocket_1x15_P2.54mm_Vertical
J13: Extra Pins; PinHeader_2x03_P2.54mm_Vertical
M2.5: CMH; MountingHole_2.7mm_M2.5
R1, R2, R3, R4, R5, R6, R7, R8: 10k; R_0603_1608Metric
R9: 350?; R_0603_1608Metric
VR1: LM1117IMPX-5.0; SOT230P700X180-4N

Connections:
/3.3V: J1.1, J1.17
/5V: C2.1, C3.1, C4.1, J3.2, J5.1, J5.4, J7.3, J9.1, J9.4, J12.1, J13.1, J14.2, J16.3, R1.2, R3.2, R5.2, R7.2, VR1.2, VR1.4
/Analog_0: J9.2, J12.12
/Analog_1: J12.11, J16.1
/Analog_2: J12.10, J16.4
/Analog_3: J12.9, J14.3
/Controller/A6: J12.6, J13.3
/Controller/A7: J12.5, J13.2
/Controller/D11: J11.14, J13.4
/Controller/D12: J11.15, J13.5
/Digital_0: J4.2, J5.3, J11.5
/Digital_1: J3.4, J6.2, J11.6
/Digital_2: J3.1, J8.2, J11.7
/Digital_3: J7.2, J10.2, J11.8
/GND: C1.2, C2.2, C3.2, C4.2, D1.1, J1.6, J1.9, J1.14, J1.20, J2.5, J2.10, J2.14, J2.19, J3.3, J5.2, J7.1, J7.4, J9.3, J11.4, J12.2, J13.6, J14.1, J14.4, J16.2, R2.2, R4.2, R6.2, R8.2, VR1.1
/I2C_Clock: J1.5, J12.7
/I2C_Data: J1.3, J12.8
/Reset: J2.22, J11.3
/VCC: C1.1, J2.23, J2.24, R9.1, VR1.3
unnamed: D1.2, R9.2
unnamed: J4.1, R2.1
unnamed: J4.3, R1.1
unnamed: J6.1, R4.1
unnamed: J6.3, R3.1
unnamed: J8.1, R6.1
unnamed: J8.3, R5.1
unnamed: J10.1, R8.1
unnamed: J10.3, R7.1
