AdamSeidman/SDAQ/Boards/uV Board/Rev_B/5v_regulator.sch

## KiCad design Boards/uV Board/Rev_B/5v_regulator.sch (2022-01-30)

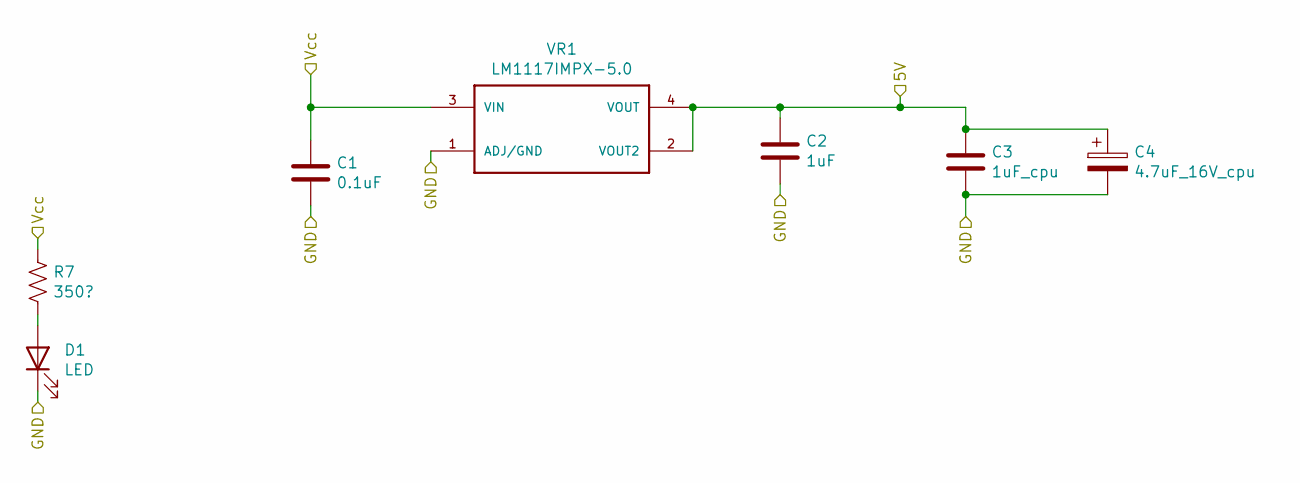
[picture p33: schematic 5v_regulator.sch]

Parts:
C1: 0.1uF; C_0603_1608Metric
C2: 1uF; C_0603_1608Metric
C3: 1uF_cpu; C_0603_1608Metric
C4: 4.7uF_16V_cpu; CP_EIA-3216-18_Kemet-A
D1: LED; LED_1206_3216Metric
R7: 350?; R_0603_1608Metric
VR1: LM1117IMPX-5.0; SOT230P700X180-4N

Connections:
5V: C2.1, C3.1, C4.1, VR1.2 (VOUT2), VR1.4 (VOUT)
GND: C1.2, C2.2, C3.2, C4.2, D1.1 (K), VR1.1 (ADJ/GND)
unnamed: D1.2 (A), R7.2
Vcc: C1.1, R7.1, VR1.3 (VIN)
