AdamSeidman/SDAQ/Boards/uV Board/Rev_B/Holes.sch

## KiCad design Boards/uV Board/Rev_B/Holes.sch (2022-01-30)

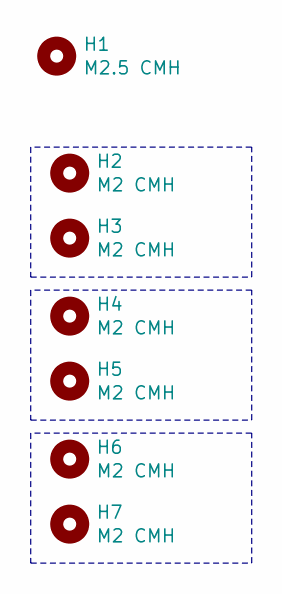
[picture p34: schematic Holes.sch]

Parts:
H1: M2.5 CMH; MountingHole_2.7mm_M2.5
H2, H3, H4, H5, H6, H7: M2 CMH; MountingHole_2.2mm_M2
