AdamSeidman/SDAQ/Boards/uV Board/Rev_B/StrainGuage.sch

## KiCad design Boards/uV Board/Rev_B/StrainGuage.sch (2022-01-30)

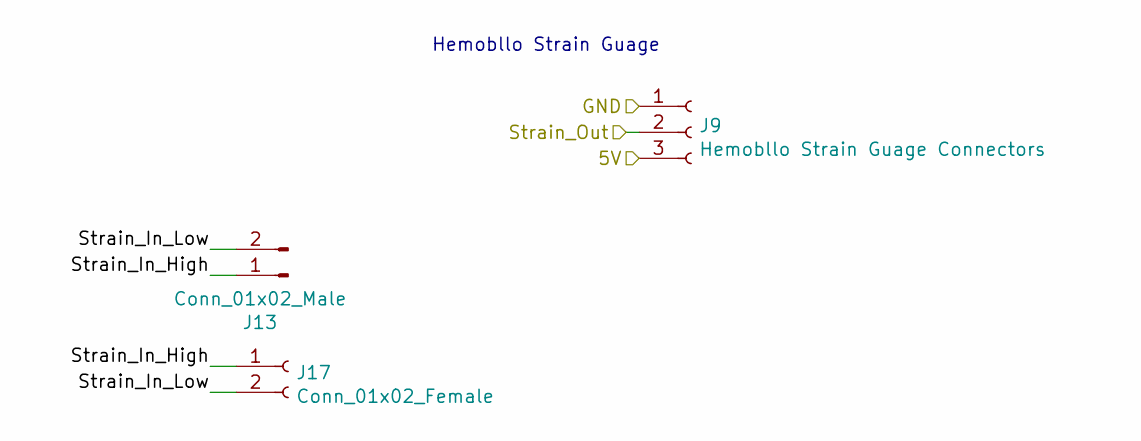
[picture p35: schematic StrainGuage.sch]

Parts:
J9: Hemobllo Strain Guage Connectors; PinSocket_1x03_P2.54mm_Vertical
J13: Conn_01x02_Male; PinHeader_1x02_P2.54mm_Vertical
J14: Conn_01x02_Female; PinSocket_1x02_P2.54mm_Vertical

Connections:
5V: J9.3
GND: J9.1
Strain_In_High: J13.1, J14.1
Strain_In_Low: J13.2, J14.2
Strain_Out: J9.2

Notes on the sheet:
Hemobllo Strain Guage
