AdamSeidman/SDAQ/Boards/uV Board/Rev_B/controller.sch

## KiCad design Boards/uV Board/Rev_B/controller.sch (2022-01-30)

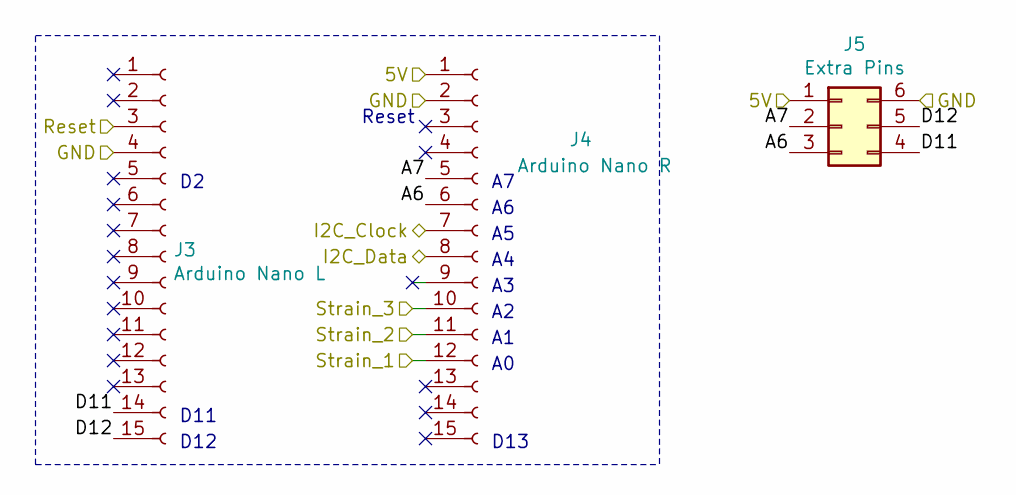
[picture p36: schematic controller.sch]

Parts:
J3: Arduino Nano L; PinHeader_1x15_P2.54mm_Vertical
J4: Arduino Nano R; PinHeader_1x15_P2.54mm_Vertical
J5: Extra Pins; PinHeader_2x03_P2.54mm_Vertical

Connections:
5V: J4.1, J5.1
A6: J4.6, J5.3
A7: J4.5, J5.2
D11: J3.14, J5.4
D12: J3.15, J5.5
GND: J3.4, J4.2, J5.6
I2C_Clock: J4.7
I2C_Data: J4.8
Reset: J3.3
Strain_1: J4.12
Strain_2: J4.11
Strain_3: J4.10

Notes on the sheet:
Reset
D13
D12
D11
