AdamSeidman/SDAQ/(commit log)

2021-09-24 Start of PI and μV board schematics
    [RevA.kicad_pcb, RevA.sch, StrainGuage.sch, controller.sch]
2021-09-24 Added thermocouple sheet
    Also moved around some stuff for clarity, and added some text.
    [RevA.sch, Thermo_1.sch, Thermocouple.sch]
2021-10-01 Added a lot to the microVolt board.
    [RevA.sch, StrainGuage.sch, Thermocouple.sch, controller.sch]
2021-10-02 Created Rev_B of the MicroVolt Board. Edited RevA of ADC Board.
    Deleted CAN infrastructure in Rev_B, and added I2C "infrastructure." Better labeled arduino nano pins within controller sheet. Imported pins from controller sheet out to board. Added controller, pull up and pulldown resistor sheets, and a button inputs sheet.
    [Button Inputs.sch, Pull Up&Down.sch, RevA.sch, Rev_B.kicad_pcb, Rev_B.sch, StrainGuage.sch, Thermo_1.sch, Thermocouple.sch]
2021-10-08 Copied controller board from micro board to ADC board. Created pull up/down sheets and populated them.
    Also copied over main set of header pins into ADC sheet.
    [Button Inputs.sch, Pull Up&Down.sch, RevA.sch, controller.sch]
2021-10-08 Initial Main Board Upload
    [Baja_Pi_Expansion.kicad_pcb, Baja_Pi_Expansion.sch]
2021-10-08 Updated Baja_Pi_Expansion with everything but regulator
    [5v_regulator.sch, Baja_Pi_Expansion.sch]
2021-10-08 Added 5V Regulator Schematic
    [5v_regulator.sch]
2021-10-08 Added Mounting Holes to Main Board
    [5_holes.sch, 5v_regulator.sch, Baja_Pi_Expansion.sch]
2021-10-08 Created analog in sheets on ADC board, populated them, and connected them to controller. Defined Interconnect pins. Placed mounting holes.
    Converted some strain gauge connections to nets.
    [Analog Input.sch, Pull Up&Down.sch, Regulator.sch, RevA.sch, Rev_B.sch, StrainGuage.sch, controller.sch]
2021-10-08 Added a Majority of Main Board Footprints
    [5_holes.sch, 5v_regulator.sch, Baja_Pi_Expansion.sch]
2021-10-08 Added regulator to ADC and micro boards. Added actual connectors for the strain gauge modules.
    [5v_regulator.sch, Analog Input.sch, Pull Up&Down.sch, RevA.sch, Rev_B.sch, StrainGuage.sch, controller.sch]
2021-10-08 Added \#Parts
    (For 5V Regulator)
    [5v_regulator.sch, 91601-306LFc.stp, 91601-308LFc.stp, 91601-412ALFc.stp, Baja_Pi_Expansion.sch, keystone-PN1027.STEP]
2021-10-08 Connected power regulator to ADC and micro boards. Added no connects to headers on ADC board. Preformed some footprinting operations on ADC board.
    [5v_regulator.sch, Analog Input.sch, Pull Up&Down.sch, RevA.sch, Rev_B.sch, controller.sch]
2021-10-08 Fixed LM1117 Symbol
    [5v_regulator.sch]
2021-10-08 Update LM1117IMPX-5.0.lib
    Pin Naming Change
2021-10-08 Created Main Board netlist
    [5v_regulator.sch]
2021-10-08 Created Main Board PCB Template
    [Baja_Pi_Expansion.kicad_pcb]
2021-10-08 Fixed regulator nonsense on ADC board. Rules checked both ADC and micro boards. Fixed interconnect on ADC board.
    [5v_regulator.sch, Analog Input.sch, Pull Up&Down.sch, RevA.sch, Rev_B.sch, StrainGuage.sch, controller.sch]
2021-10-08 Roughed out Main Board PCB
    [Baja_Pi_Expansion.kicad_pcb]
2021-10-08 Placed Pi Header and Created .dsn File for Main Board
    [Baja_Pi_Expansion.dsn, Baja_Pi_Expansion.kicad_pcb]
2021-10-08 Updated .dsn Files and Power Planes/Keepouts for Main Board
    [Baja_Pi_Expansion.kicad_pcb, Baja_Pi_Expansion_betterGND.dsn]
2021-10-08 Finished Main Board Routing
    Made 4 Layers
    [Baja_Pi_Expansion.kicad_pcb, Baja_Pi_Expansion_4.dsn, Baja_Pi_Expansion_4B.dsn]
2021-10-10 Gerber Files
    [Baja_Pi_Expansion-B_Cu.gbr, Baja_Pi_Expansion-B_Mask.gbr, Baja_Pi_Expansion-B_Paste.gbr, Baja_Pi_Expansion-B_SilkS.gbr, Baja_Pi_Expansion-Edge_Cuts.gbr, Baja_Pi_Expansion-F_Cu.gbr, Baja_Pi_Expansion-F_Mask.gbr, Baja_Pi_Expansion-F_Paste.gbr]
2021-10-10 Began PCB layout for ADC board. Fixed annotations for ADC and micro boards.
    [Analog Input.sch, Pull Up&Down.sch, RevA.sch]
2021-10-10 Copied RevA Board to \RevA1
    [5_holes.sch, 5v_regulator.sch, Baja_Pi_Expansion.dsn, Baja_Pi_Expansion.kicad_pcb, Baja_Pi_Expansion.sch, Baja_Pi_Expansion_4.dsn, Baja_Pi_Expansion_4B.dsn, Baja_Pi_Expansion_betterGND.dsn]
2021-10-10 Removed Main Board Gerber.zip
2021-10-11 Updated Pullup/Pulldown Jumper Mistake
    [Baja_Pi_Expansion.sch]
2021-10-11 Completed footprint associations for ADC board. Generated netlist for ADC board. Started PCB design for ADC board.
    [5v_regulator.sch, Analog Input.sch, Pull Up&Down.sch, RevA.kicad_pcb, RevA.sch, controller.sch]
2021-10-12 Preparing to Re-route RevA1
    [Baja_Pi_Expansion.dsn, Baja_Pi_Expansion_4.dsn, Baja_Pi_Expansion_4B.dsn, Baja_Pi_Expansion_betterGND.dsn]
2021-10-12 /RevA1 Board Set up For Auto-Routing
    [Baja_Pi_Expansion.dsn, Baja_Pi_Expansion.kicad_pcb]
2021-10-12 Added Gerber Files and Main_Board.xlsx
    [Baja_Pi_Expansion-B_Cu.gbr, Baja_Pi_Expansion-B_Mask.gbr, Baja_Pi_Expansion-B_Paste.gbr, Baja_Pi_Expansion-B_SilkS.gbr, Baja_Pi_Expansion-Edge_Cuts.gbr, Baja_Pi_Expansion-F_Cu.gbr, Baja_Pi_Expansion-F_Mask.gbr, Baja_Pi_Expansion-F_Paste.gbr]
2021-10-14 Edited footprints to be correct. Began PCB layout. Removed extraneous files.
    [5v_regulator.sch, Analog Input.sch, Button Inputs.sch, Pull Up&Down.sch, Regulator.sch, RevA.kicad_pcb, RevA.sch, controller.sch]
2021-10-15 Created order excel form.
    [Orders.xlsx]
2021-10-15 Finished order sheet.
    [Orders.xlsx]
2021-10-17 Prepared 3.5mm Spring Connectors for Main Board
    [Baja_Pi_Expansion.kicad_pcb]
2021-10-17 Completed Main Board Routing with 3.5 mm Connectors
    [Baja_Pi_Expansion.dsn, Baja_Pi_Expansion.kicad_pcb]
2021-10-17 Completed Main Board Revision A
    [Baja_Pi_Expansion-B_Cu.gbr, Baja_Pi_Expansion-B_Mask.gbr, Baja_Pi_Expansion-B_Paste.gbr, Baja_Pi_Expansion-B_SilkS.gbr, Baja_Pi_Expansion-Edge_Cuts.gbr, Baja_Pi_Expansion-F_Cu.gbr, Baja_Pi_Expansion-F_Mask.gbr, Baja_Pi_Expansion-F_Paste.gbr]
2021-10-22 Determined correct spacing for Arduino nano pins. Placed down voltage regulator and associated components.
    [RevA.kicad_pcb]
2021-11-07 Added 12-pin and 4-pin spring terminal footprints. Updated footprints for ADC board. Continued work on PCB layout of ADC board.
    [Analog Input.sch, Orders.xlsx, Pull Up&Down.sch, RevA.kicad_pcb]
2021-11-23 Imported 4 pin spring terminals. Replaced 12 pin terminals with 4 pin terminals on ADC board. Placed 4 pin terminals on PCB.
    [Analog Input.sch, Pull Up&Down.sch, RevA.kicad_pcb]
2022-01-22 Moved around components on the ADC board PCB. Assigned footprints to microVolt board components.
    Tried to add 6-pin spring connector to custom schematics list.
    [5v_regulator.sch, RevA.kicad_pcb, Rev_B.sch, StrainGuage.sch, controller.sch]
2022-01-30 Created and layed out most of PCB for microvolt board. Removed one strain module, and added multiple mounting holes for the boards to be placed on.
    [5v_regulator.sch, Analog Input.sch, Holes.sch, RevA.kicad_pcb, RevA.sch, Rev_B.sch, StrainGuage.sch, controller.sch]
2022-02-03 Prototype reversed enginnered schmatic of the strain gauge + IMU board
    [Strain_Guage_Schematic.kicad_pcb, Strain_Guage_Schematic.sch]
2022-02-03 Finished placing and organizing PCB components for the ADC board, and prepped board for auto-routing.
    [RevA.kicad_pcb]
2022-02-03 Exported ADC to spectra design file, beginning first autorouting.
    [RevA.dsn, RevA.kicad_pcb]
2022-02-03 Finished autorouting ADC board and placing text.
    [RevA.dsn, RevA.kicad_pcb]
2022-02-03 Added Gerber Files for ADC revA
    [RevA-B_Cu.gbr, RevA-B_Mask.gbr, RevA-B_Paste.gbr, RevA-B_SilkS.gbr, RevA-Edge_Cuts.gbr, RevA-F_Cu.gbr, RevA-F_Mask.gbr, RevA-F_Paste.gbr]
2022-02-03 Main Board: Copied RevA1 into RevB
    [5_holes.sch, 5v_regulator.sch, Baja_Pi_Expansion.dsn, Baja_Pi_Expansion.kicad_pcb, Baja_Pi_Expansion.sch]
2022-02-03 Updated Main Board RevB to reflect recent changes
    [5_holes.sch, Baja_Pi_Expansion.sch]
2022-02-03 Updated Main-RevB annotations and added placeholder for Breadboard_Testbed
    [Baja_Pi_Expansion.sch]
2022-02-03 Removed footprints from PCB on Main-RevB
    [Baja_Pi_Expansion.kicad_pcb]
2022-02-03 Turned Main-RevB from 4 layers into 2
    [Baja_Pi_Expansion.kicad_pcb]
2022-02-03 Added Footprints and .net to Main-RevB
    [Baja_Pi_Expansion.kicad_pcb]
2022-02-03 Begin to put components in place on Main-RevB
    [5_holes.sch, Baja_Pi_Expansion.kicad_pcb]
2022-02-03 Finished placing most components: Main-RevB
    [Baja_Pi_Expansion.kicad_pcb]
2022-02-03 Main-RevB Pre-route complete. Waiting on footprint confirmation
    [Baja_Pi_Expansion.kicad_pcb, Baja_Pi_Expansion.sch]
2022-02-03 Begin Breadboard-Testbed RevA
    [Breadboard-Testbed.kicad_pcb, Breadboard-Testbed.sch]
2022-02-03 Finished Breadboard-Testbed RevA Schematic
    [Breadboard-Testbed.sch]
2022-02-03 Generated Netlist for Breadboard-Testbed
    [Breadboard-Testbed.sch]
2022-02-03 Fixed Breadboard-Testbed RevA arrangement, need to fix pi lineup
    [Breadboard-Testbed.sch]
2022-02-04 Finished Test-RevA layout Pre-route
    [Breadboard-Testbed.kicad_pcb, Breadboard-Testbed.sch]
2022-02-04 Routing Complete Test-RevA board
    [Breadboard-Testbed.dsn, Breadboard-Testbed.kicad_pcb]
2022-02-04 Testbed-RevA postroute complete
    [Breadboard-Testbed.kicad_pcb, Breadboard-Testbed.sch]
2022-02-04 Added gerber files for Breadboard_Testbed-RevA
    [Breadboard-Testbed-B_Cu.gbr, Breadboard-Testbed-B_Mask.gbr, Breadboard-Testbed-B_Paste.gbr, Breadboard-Testbed-B_SilkS.gbr, Breadboard-Testbed-Edge_Cuts.gbr, Breadboard-Testbed-F_Cu.gbr, Breadboard-Testbed-F_Mask.gbr, Breadboard-Testbed-F_Paste.gbr]
2022-02-04 Breadboard-test save files
    [Breadboard-Testbed.kicad_pcb]
2022-02-04 Finalized Main-RevB board
    [Baja_Pi_Expansion.kicad_pcb]
2022-02-04 Added Gerber files for Main-RevB
    [Baja_Pi_Expansion-B_Cu.gbr, Baja_Pi_Expansion-B_Mask.gbr, Baja_Pi_Expansion-B_Paste.gbr, Baja_Pi_Expansion-B_SilkS.gbr, Baja_Pi_Expansion-Edge_Cuts.gbr, Baja_Pi_Expansion-F_Cu.gbr, Baja_Pi_Expansion-F_Mask.gbr, Baja_Pi_Expansion-F_Paste.gbr]
2022-02-04 [ImgBot] Optimize images
    *Total -- 1,016.30kb -> 924.98kb (8.99%)
    /Boards/Breadboard_Testbed/RevA/Gerber/Breadboard_Testbed-RevA.png -- 236.40kb -> 212.63kb (10.06%)
    /Boards/Main Board/#Gerber/pcb_options.png -- 139.95kb -> 126.25kb (9.79%)
    /Boards/ADC Board/RevA1/Gerber/SDAQ_ADC_Board_RevA.png -- 476.82kb -> 434.37kb (8.9%)
    /Boards/Main Board/#Gerber/#Zips/Main_Board-RevB.png -- 163.13kb -> 151.74kb (6.98%)
2022-02-05 In process of updating ADC board to remove 5V connection from PI. Also commiting small changes to uV board.
    [Pull Up&Down.sch, RevA.kicad_pcb, RevA.sch, Rev_B.sch]
2022-02-05 Fixed associations between screw terminals and necessary pins. Updating ADC board to fix those PI pins.
    [RevA.kicad_pcb, RevA_1.dsn, RevA_2.dsn]
2022-02-05 Finished the reassociation of the PI pins, created the .dril and Gerber files and zipped them up.
    [RevA-B_Cu.gbr, RevA-B_Mask.gbr, RevA-B_Paste.gbr, RevA-B_SilkS.gbr, RevA-Edge_Cuts.gbr, RevA-F_Cu.gbr, RevA-F_Mask.gbr, RevA-F_Paste.gbr]
2022-02-05 Fixed Main-RevB autorouting
    [Baja_Pi_Expansion.dsn, Baja_Pi_Expansion.kicad_pcb]
2022-02-05 Updated Main-RevB Gerbers
    [Baja_Pi_Expansion-B_Cu.gbr, Baja_Pi_Expansion-B_Mask.gbr, Baja_Pi_Expansion-B_Paste.gbr, Baja_Pi_Expansion-B_SilkS.gbr, Baja_Pi_Expansion-Edge_Cuts.gbr, Baja_Pi_Expansion-F_Cu.gbr, Baja_Pi_Expansion-F_Mask.gbr, Baja_Pi_Expansion-F_Paste.gbr]
2022-02-05 Added Main Board .zip files and pictures
2022-02-05 [ImgBot] Optimize images
    /Boards/Main Board/#Gerber/#Zips/Main_Board-RevB.png -- 496.19kb -> 379.79kb (23.46%)
2022-02-05 New strain gauge schematic + pcb
    [LM358.step, LM358M_NOPB.step, Regulator.sch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]
2022-02-07 Added order number to strain guage schematic
    [Strain_Guage_Schematic.kicad_pcb]
2022-02-11 Added capacitor resistances
    [Strain_Guage_Schematic.kicad_pcb, Strain_Guage_Schematic.sch]
2022-02-12 Began the schmatic of the Xsense implemented with a arduino nano, added LED's to indcate board is powered
2022-02-14 Small error in strain gauge schematic, C4 footprint a bit big
    [Regulator.sch, Strain_Guage_Schematic.kicad_pcb]
2022-02-25 Added template for arduino code
2022-02-26 Got I2C working and got the code to get all active I2C buses
2022-02-26 Split i2c-test into i2c-read and i2c-scan
    i2c-read and i2c-scan will be used with scheduler in gui.py
    Changed config.ini to be split by commas for board name and ID (used for comparison and i2c; e.g. which board is connected and display it dropdown menu).
2022-02-28 Finished Analog test interface for I2C (and ADC board)
2022-02-28 Added test data (temporary) to Arduino code
2022-03-16 Created ADC board RevB
    [32M1-A_ATM-L.step, 32M1-A_ATM-M.step, 32M1-A_ATM.step, 5v_regulator.sch, Analog Input.sch, Analog.sch, BoardID.sch, Button Inputs.sch]
2022-03-16 Cleanup before pcb
    [RevA.kicad_pcb]
2022-03-16 Began footprint associations for rev b
    [5v_regulator.sch, Analog.sch, BoardID.sch, Input.sch, RevA.sch, controller.sch]
2022-03-18 Created PCB for Rev B
    [BoardID.sch, Input.sch, RevA.kicad_pcb, RevA.sch, controller.sch]
2022-03-18 Continued making RevB PCB
    [5v_regulator.sch, Input.sch, RevA.kicad_pcb, RevA.sch, controller.sch]
2022-03-21 Completed placements on RevB, prepared for auto routing.
    [RevA.kicad_pcb]
2022-03-21 Completed RevB autorouting
    [RevA.dsn, RevA.kicad_pcb, RevA_1.dsn, RevA_2.dsn, RevB.dsn, RevB1.dsn]
2022-03-22 Finished rev B routing and screenshots
    [RevA-B_Cu.gbr, RevA-B_Mask.gbr, RevA-B_Paste.gbr, RevA-B_SilkS.gbr, RevA-Edge_Cuts.gbr, RevA-F_Cu.gbr, RevA-F_Mask.gbr, RevA-F_Paste.gbr]
2022-03-25 Created Relay Board RevA
    [5v_regulator.kicad_sch, 5v_regulator.sch, BoardID.kicad_sch, BoardID.sch, controls.kicad_sch, relay.kicad_sch, relay_board.kicad_pcb, relay_board.kicad_sch]
2022-03-25 Prepared RevA Relay Board PCB
    [relay_board.kicad_pcb, relay_board.kicad_sch]
2022-03-25 Relay Board RevA Rough PCB
    [relay_board.kicad_pcb]
2022-03-25 Created Design File for Relay Board Rev A
    [relay_board.dsn, relay_board.kicad_pcb]
2022-03-25 Created Session File for Relay Board Rev A
2022-03-25 Added Screw Terminal Labels for Relay Board Rev a
    [relay_board.dsn, relay_board.kicad_pcb]
2022-03-25 Relay Board Rev A Complete
    [relay_board-B_Cu.gbr, relay_board-B_Mask.gbr, relay_board-B_Paste.gbr, relay_board-B_Silkscreen.gbr, relay_board-Edge_Cuts.gbr, relay_board-F_Cu.gbr, relay_board-F_Mask.gbr, relay_board-F_Paste.gbr]
2022-03-25 Created Gerber Zip for Relay Board Rev A
2022-03-25 Added RevC of Main Board
    [5_holes.sch, 5v_regulator.sch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]
2022-03-26 updated LED resistor on relay board rev A
    [relay_board.kicad_sch]
2022-03-26 Added Strain Gauge Schematic
    Added Strain Gauge Schematic with notes. Determined only thing needed to change was +5V regulator.
2022-03-26 Strain Gauge Schematic
    Initial creation of strain gauge schematic. Has some parts missing relating to sensor and outputs.
    [StrainPassthroughBoard.kicad_pcb, StrainPassthroughBoard.sch, strain.sch]
2022-03-26 Added everything from SDAQ
    Worked on GUI for RPM Data Collector
    Worked on generic GUI for all boards
    Implemented valueFrame for putting options for RPM's GUI
    Fixed issues in shift_around_val and added combine_data (for avg) in tools.py
    Added cat jam
2022-03-30 Pull from SDAQ with recent changes. Made order for SDAQ and Brakes PCBs.
    [26Mar23_SDAQ_and_Brakes_order.csv]
2022-03-31 Actually moved the csv into the Orders sheet
    [26Mar23_SDAQ_and_Brakes_order.csv, Orders.xlsx]
2022-03-31 Updated order sheet name
    [Orders.xlsx]
2022-04-01 Added Main_RevD with New Board
    [5_holes.sch, 5v_regulator.sch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]
2022-04-19 Adding tons of random parsing scripts
    (Needs cleanup)
    [Baja_Pi_Expansion.kicad_pcb, RevA.kicad_pcb]
2022-04-19 Added missing Brakes-Parse code
2022-04-22 Uploaded low end calibration data
2022-04-22 Working Algorithm-Wrong Calibration?
2022-04-22 Added strain gauge calibration document
2022-04-23 Minor Readability Changes to Pressure.py
2022-04-23 Uploaded data for 4/22 calibration
2022-04-24 [ImgBot] Optimize images
    *Total -- 11,118.26kb -> 10,638.03kb (4.32%)
    /Python/#old/GUI_MAX/src/assets/image_1.png -- 5.73kb -> 3.31kb (42.27%)
    /Assets/cat_jam2.gif -- 168.46kb -> 121.62kb (27.8%)
    /Assets/cat_jam.gif -- 171.39kb -> 124.42kb (27.4%)
    /Resources/GPIO Pins for Raspberry Pi 4 (1).jpg -- 692.13kb -> 542.52kb (21.62%)
    /Resources/Strain Gauge Schematic With Notes.png -- 1,102.27kb -> 970.21kb (11.98%)
    /Resources/GPIO Pins for Raspberry Pi 4 (2).jpg -- 144.06kb -> 127.78kb (11.3%)
    /Python/#old/GUI_MAX/src/assets/button_4.png -- 1.66kb -> 1.50kb (9.98%)
    /Boards/ADC Board/RevB/Gerber/SDAQ_ADCBoard_RevB.png -- 335.34kb -> 306.70kb (8.54%)
    /Python/#old/GUI_MAX/src/assets/button_5.png --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
2022-04-24 Adding Raw Data from 4/22
    [raw_cornering_1.csv, raw_cornering_2.csv, raw_cornering_3.csv, raw_dock_drop_1.csv, raw_dock_drop_2.csv, raw_dock_drop_3.csv]
2022-04-25 Added garbage tie rod data
    [tie_rod_converted_1.csv, tie_rod_converted_2.csv, tie_rod_converted_3.csv]
2022-04-25 Parsed Mock Tie Rod Data
2022-05-28 Added mosfet to relay and 5V regulator to schematic
    [5v_regulator.kicad_sch, 5v_regulator.sch, BoardID.kicad_sch, BoardID.sch, Regulator.sch, controls.kicad_sch, relay.kicad_sch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]
2022-05-28 Added new components to PCB
    [5v_regulator.kicad_sch, relay_board.kicad_pcb, relay_board.kicad_sch, relay_new.kicad_sch]
2022-05-28 Routed relay board rev b
    [relay_board.dsn, relay_board.kicad_pcb]
2022-05-28 [ImgBot] Optimize images
    *Total -- 8,396.21kb -> 8,243.75kb (1.82%)
    /Python/#old/GUI_MAX/src/assets/button_5.png -- 1.68kb -> 1.61kb (4.13%)
    /Python/#old/GUI_MAX/src/assets/button_2.png -- 2.54kb -> 2.48kb (2.31%)
    /Python/#old/GUI_MAX/src/assets/button_1.png -- 2.49kb -> 2.47kb (0.82%)
    /Assets/cat-jam.gif -- 8,040.73kb -> 7,984.81kb (0.7%)
    /Python/#old/GUI_MAX/src/assets/button_3.png -- 1.52kb -> 1.52kb (0.38%)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
